donzelot/Transceiver/CHANGELOG.txt

----Version 9.4.0----
+HARDW: Wolf-2: Добавлена новая экспериментальная УКВ плата 85-2700МГц. Автор R7KBI
+HARDW: Стандартизирована распиновка разъёма External для всех версий TRX, схема подключения находится в файле Stuff/Manuals/External.png. Автор R3TJL
+STM32: Добавлена регулировка громкости самопрослушивания в CW. Автор RA3RBE, Tnx SP7MFR
+STM32: Удалена опция отключения самопрослушивания в связи с возможностью плавной регулировки громкости.  Автор RA3RBE
+STM32: Изменен порядок регулировок в меню CW. Автор RA3RBE
+STM32: Исправление вывода даты в меню настроек. Автор RA3RBE
+STM32: Добавлено выключение режима MUTE вращение регулятора громкости. Выключение этого режима клавишей не отменяется. Автор RA3RBE, Tnx UR7CQ
+STM32: Wolf-2: Добавлена поддержка новой УКВ платы
+STM32: Вернул свайп по водопаду в режиме Center, но инвертировал в Free Tune, Tnx R3TJL
+STM32: Wolf-2: Кнопка VHF переключает активные УКВ бенды, а не только 2м, Tnx Adi
+STM32: Исправлена проблема с зашкаливанием S-метра, Tnx SP7MFR
+STM32: W-Lite: Добавленя матричная обработка клавиш тангенты. Автор RA3RBE
+STM32: В режиме Double всегда отображается второй VFO на водопаде (без необходимости активации Show Sec VFO), Tnx SP7MFR
+STM32: На спектре отображаются границы Manual Notch фильтра, Tnx EA7HOG
+STM32: Обновлён шаг по умолчанию для WFM
+STM32: Добавлена калибровка "FAN Motherboard", включающая вентилятор не только на превышение температуры RF-платы, но и на температуру STM32, Tnx SP7MFR
+STM32: Настройка "Bottom navi buttons" теперь выбирает позицию расположения навигационных кнопок (выкл\центр\по краям), Tnx R3TJL
+STM32: Новая настройка "SPLIT type", в режиме DX - идёт управление частотой DX, в режиме CrossBand синхронно для двух VFO, для Free меняется только частота RX, Tnx UR7CQ
+STM32: Исправлена работа CW макросов при выключенном CW Keyer, Tnx SP7MFR
+STM32: Добавлена кнопка выхода в FT8 декодере, Tnx EA5GSA

----Version 9.3.1----
+HARDW: W-Lite: Исправление типов диодов в схеме MotherBoard. Автор R7KBI
+STM32: W-Lite: Исправлена регулировка скорости водопада. Автор RA3RBE
+STM32: Для CW моды добавил дополнительное предусиление в ПЧ, Tnx RU4PN
+STM32: Обдув в режиме Full теперь работает до установленной температуры, а не до Medium stop, Tnx RU4PN
+STM32: Частота по умолчанию для 2м бенда установлена в 145.500, Tnx R7KBI
+STM32: При активном Free Tune, переключение Zoom/Samples перемещает спектр в центр полосы приёма, Tnx UR7CQ
+STM32: W-Mini: добавлены дополнительные настраиваемые функциональные кнопки (FT8/VOX/...), Tnx R6DLC
+STM32: Исправлена работа функциональной кнопки MEMORY, Tnx SP7MFR
+STM32: Добавлена настройка "Center After Idle", центрирующая спектр Free Tune во время бездействия более 20 секунд, Tnx R7KBI
+STM32: Изменение положения навигационных кнопок на 8-ми кнопочной версии, Tnx SP7MFR
+STM32: В сервис Self Test добавлена палитра для проверки подключения шины LCD панелей
+STM32: Устранение различных ошибок
+STM32: W-Lite: Добавлена настройка экрана (Mirror) при первом старте программы. Автор RA3RBE
+STM32: Обновлены системные библиотеки

----Version 9.3.0----
+HARDW: Wolf-Motherboard-rev34: Исправления в посадочных местах, переход на USB Type-C, разъём для подключения I2C периферии и прочие исправления. Автор R7KBI
+HARDW: Wolf-Front-Unit-7-rev6: Исправления в посадочных местах. Автор R7KBI
+OTA: Сервер обновлений и сервисов переведён в Нидерланды
+STM32: W-Mini: Добавлена поддержка УКВ платы, Tnx R7KBI
+STM32: W-Mini: Автоматический выбор соответствующей функциональной страницы кнопок при активации режима MEMO / моды CW, Tnx R7KBI
+STM32: Добавлена регулировка ручного Notch-фильтра, Tnx EA7HOG
+STM32: Добавлена поддержка бенда 630м и трансвертеров 1.2см
+STM32: Вывод текущей даты на 7 дюймовых дисплеях, Tnx ats52
+STM32: Добавлена "запятая" в окно ручного ввода частоты, Tnx R4HID
+STM32: Устранение ошибок, Tnx ats52
+STM32: W-Lite: Включено декодирование CW сигнала
+STM32: W-Lite: Включены настройки трансвертеров
+STM32: При активации SPLIT принудительно отображается второй VFO на водопаде, Tnx UR7CQ, UT8EU
+STM32: При активации SPLIT свайп\тап по водопаду перемещает вторичный VFO, а не основной, Tnx UR7CQ
+STM32: Функция MEMORY добавлена в нижний ряд настраиваемых кнопок (через меню), Tnx SP7MFR

----Version 9.2.1----
+STM32: Устранение ошибок, Tnx Martin AD, SP7MFR

----Version 9.2.0----
+HARDW: Wolf-2: Обновлена плата УКВ, Автор RU4PN
+HARDW: W-Lite: Исправлена шелкография у стабилизаторов на материнской плате, Tnx Андрей Сергеев
+STM32: Долгое нажатие на водопад переключает режимы Free Tune / Center Tune. Автор BD6MM
+STM32: Улучшена поддержка некоторых видов SD карт, Tnx UN7LAS
+STM32: Обновлены параметры "Repeater offset, kHz" по умолчанию, Tnx SP7MFR
+STM32: Уменьшен уровень передачи записанного WAV файла, Tnx UZ5DM
+STM32: Доработки процесса OTA и прошивки с SD, Tnx RV9CT, SQ7BCN
+STM32: FFT Automatic теперь принимает 3 значения: Full - автоматический выбор верхней и нижней границ, Half - авто нижний и ручной верхний, No - ручное выставление диапазона уровней спектра. (Не забывайте выбрать нужный FFT Scale Type, чтобы диапазон уместился на экране). Tnx ats52
+STM32: ENC2 теперь корректно работает на AM/NFM/WFM модах, обновлены настройки по умолчанию, Tnx R3TKS
+STM32: Прописаны моды по умолчанию за границами бендов, Tnx RU4PN
+STM32: W-Lite: Добавлено управление 6м ФНЧ, Tnx UN7FHS
+STM32: Для 9-ти кнопочных версий (WF-100D / Wolf-2) перемещены кнопки пролистывания к центральной, чтобы надписи соответствовали расположению кнопок, Tnx SP7MFR
+STM32: Устранение ошибок, Tnx R4FZ, SP7MFR, R4HID, RU4PN

----Version 9.1.0----
+HARDW: Motherboard: Обновлён номинал резистора R10 в обвязке аудио-кодека, выбирается по необходимому усилению микрофона, Tnx R3TKS
+STM32: W-Mini: Перестроен интерфейс главного экрана. Иконки режимов работы выстроены в один ряд, увеличено место под основную частоту. Автор RA3RBE
+STM32: W-Mini: Ниже основной частоты выведена частота второго VFO. Автор RA3RBE
+STM32: W-Mini: Добавлен режим каналов. В меню установлены 20 каналов, можно менять им имена, не более 6 букв. Автор RA3RBE
+STM32: W-Mini: Изменен режим SCAN. В режиме MEMO сканирование идет по заполненным каналам памяти. Автор RA3RBE
+STM32: W-Mini: Добавлена иконка работы WiFi. Автор RA3RBE
+STM32: W-Mini: Множество мелких изменений. Автор RA3RBE
+STM32: W-Lite: Открыта регулировка RF GAIN на 6 м. Автор RA3RBE
+STM32: Обновлены настройки АРУ по умолчанию (аккуратней с импортом старых), Tnx R3RM, RU4PN
+STM32: Разделены настройки "AGC Gain target" для CW и SSB, Tnx R3RM
+STM32: Добавлена настройка HPF фильтра для DIGI мод, Tnx SP3JDZ
+STM32: Repiter mode теперь сохраняется в память частот, Tnx SP7MFR
+STM32: Переработаны настройки шага перестройки частоты: Для каждой моды выставляется свой базовый шаг, и настраивается множитель для FAST и ENC2 шагов
+STM32: Добавлена возможность настроить индивидуальный шаг перестройки для DIGI мод, Tnx SP7MFR
+STM32: Устранение ошибок, Tnx Serg, R4HID

----Version 9.0.1----
+STM32: Исправлена ошибка "Line length error", Tnx SP7MFR
+STM32: Добавлен кГц разряд при сохранении в память частоты >100МГц, Tnx SP7MFR
+STM32: Добавлена настройка "ATU Mem step, kHz", регулирующая шаг ячеек памяти автотюнера, Tnx R7KBI
+STM32: Исправлена ошибка с полным пропадаем звука в WFM

----Version 9.0.0----
+FPGA: W-Mini: Добавлены прошивки с поддержкой новых плат
+STM32: W-Lite: Добавлены команды САТ интерфейса DN,UP. Автор RA3RBE
+STM32: Начало разработки Satellite Mode (режима работы через спутники). Реализовано скачивание TLE, выбор спутника и отображение элевации\азимута для текущего QTH
+STM32: Исправлена работа команды САТ интерфейса NR, Thanks Кшисек SP7MFR. Автор RA3RBE
+STM32: Оптимизация скорости работы математических функций
+STM32: В режиме FT8 добавлена регулировка мощности основным энкодером при ТХ, Tnx RU4PN
+STM32: Wolf-2: Увеличена точность определения нажатия на кнопки лицевой панели
+STM32: Wolf-2: Добавлена возможность регулировки полосы фильтра в модах DIGI отдельным энкодером
+STM32: Ручной ввод частоты вынесен в отдельную кнопку
+STM32: По умолчанию, при сохранении частоты в память, в название канала пишется частота, далее можно отредактировать имя через меню
+STM32: Wolf-Mini: Добавлена регулировка IF Gain второстепенным энкодером
+STM32: Для каждого канала памяти индивидуально сохраняется настройка CTCSS, Tnx SP7MFR+SP7GRV
+STM32: Вернул старый CW декодер, но с исправлениями проблем, Tnx BD6MM
+STM32: Улучшена защита от проглатывания первой точки в CW, Tnx BD6MM, Serg
+STM32: Переработан код электронного ключа для более точной генерации символов, Tnx BD6MM
+STM32: Добавлена настройка CW "Edges smooth, ms", отвечающая за сглаживание фронтов сигнала
+STM32: При выходе из FT8 декодера трансивер возвращается в предыдущую частоту\моду, Tnx UN7LAS
+STM32: Устранение ошибок, Tnx UZ5DM, ats52, EA7HOG, BD6MM

----Version 8.6.4----
+STM32: W-Lite: Добавлены команды САТ интерфейса NB,NR,NT,PA,RA. Автор RA3RBE
+STM32: W-Lite: Расширена область приема АМ вниз до 100кгц, Автор RA3RBE
+STM32: Вернули настройку Encoder2 on fall, настраивающую режим работы ENC2
+STM32: Переделан механизм анти-дребезга энкодера (аккуратнее с импортом старых калибровок ENC2, могут не подойти)
+STM32: Вернул регулировку уровня предусиления перед сжатием сигнала "CESSB Compress"
+STM32: Добавлена поддержка трансвертеров на 144мгц, Tnx R6DLC
+STM32: Устранение ошибок, Tnx R6DLC, RA9N

----Version 8.6.3----
+STM32: W-Lite: Подвинул индикатор полосы пропускания и подпись под ним, Автор RA3RBE
+STM32: Устранение ошибок, Tnx R3RM, R7KBI

----Version 8.6.0----
+STM32: W-Lite: Расширил место под АТТ, Автор RA3RBE
+STM32: W-Lite: Перестановки в карусели, Автор RA3RBE
+STM32: W-Lite: Убрал клавишу IF и вместо нее сделал CESSB, Автор RA3RBE
+STM32: W-Lite: Ограничил перестройку "по кругу" IF GAIN, Автор RA3RBE
+STM32: W-Lite: Вернул в карусель клавиши BAND+, BAND- и NB, Автор RA3RBE
+STM32: W-Lite: на спектре выводятся маркеры сохраненных частот, маяков, смещение от несущей в SAM
+STM32: W-Mini: Добавлен "пиксель" в правой части экрана, отображающий статус WiFi соединения, Tnx R7KBI
+STM32: W-Mini: управление NB выведено в нижнюю карусель функциональных кнопок, Tnx R7KBI
+STM32: Переработка Noise Blanker, Tnx R3RM, RA3RBE
+STM32: Переделаны функции-обработчики сигналов с энкодеров, Tnx RA3RBE
+STM32: Добавлена настройка VCXO Correction для точной подстройки отклонения частоты генератора от эталонного
+STM32: Добавлена поддержка 12.8МГц TCXO, Tnx ats52
+STM32: Разделены настройки Mic Gain для AM и FM
+STM32: На спектре выводятся маркеры сохраненных в память частот, Tnx Martin AD
+STM32: Добавлена настройка "FFT BW Position" для регулировки положения отрисовки полосы приёма на FFT\WTF
+STM32: Добавлен режим "Delay" для "FFT BW Position" (отрисовка с временной задержкой), Tnx ats52
+STM32: ATU теперь хранит настройки с шагом в 50кГц для каждой антенны, Tnx UT8EU
+STM32: Увеличено количество каналов памяти на 7 дюймовках, Tnx SP7MFR
+STM32: Оптимизация работы CW декодера
+STM32: Добавлена настройка "A/B Balance", регулирующая баланс каналов в режимах двойного приёмника A+B и A&B, Tnx SP7MFR
+STM32: Если режим вторичного энкодера переключен на "MEM", и есть сохранённые частоты в память, то функция SCAN ведётся по ним, Tnx EA7HOG
+STM32: Отключена компрессия в CESSB, оставил только контроль огибающей квадратуры
+STM32: Устранение ошибок, Tnx RV9CT, UN7FHS, SP7MFR, UZ5DM, BD6MM, R7KBI, Adi, Vit

----Version 8.5.1----
+STM32: Устранение ошибок

----Version 8.5.0----
+HARDW: Доработки по плате тюнера Wolf-2, Tnx RU4PN
+STM32: Доработки по работе основного энкодера в системном меню, Tnx RA3RBE
+STM32: Уменьшен шаг калибровки шунта INA226, Tnx R5ZX
+STM32: Добавлена поддержка плат с 4 антенными выходами, Tnx R2AJI
+STM32: Изменён цвет подсветки при отображении второго VFO на спектре, Tnx SP7MFR
+STM32: Добавлены узкополосные SSB фильтры, Tnx SP7MFR
+STM32: Для RTTY декодера устанавливается узкая полоса фильтра, Tnx EA7HOG
+STM32: Добавлено меню редактирования названий каналов памяти, Tnx Martin AD
+STM32: Записи эфира складываются в отдельную директорию Recordings, Tnx Martin AD
+STM32: W-Lite: Убраны квадраты вокруг индикаторов режимов как не несущие полезной нагрузки, только загромождающие экран, Автор RA3RBE
+STM32: W-Lite: Индикаторы распределены равномерно по сторонам экрана визуально разгружая центр экрана, Автор RA3RBE
+STM32: W-Lite: Выведена на экран частота второго VFO, Автор RA3RBE
+STM32: W-Lite: Режимы второго энкодера выделены на экране белой рамочкой, Автор RA3RBE
+STM32: W-Lite: Удалена клавиша "LOCK", блокировка трансивера осуществляется нажатием на кнопку второго энкодера, Автор RA3RBE
+STM32: W-Lite: Скорость работы основного энкодера уменьшается в 10 раз при переходе в меню. Это удобно при наборе имени и прочего, Автор RA3RBE
+STM32: W-Lite: Добавлены 20 ячеек памяти. Можно запоминать в них текущую частоту, читать частоту из памяти и присваивать ее основной частоте, Автор RA3RBE
+STM32: W-Lite: Можно стирать содержимое ячейки, если повторно записать в нее ту же самую частоту, Автор RA3RBE
+STM32: W-Lite: Режим работы с памятью выбирается нажатием на кнопку второго энкодера до появления надписи "Memory". Перебирать каналы можно вращением второго энкодера. Запись в память и извлечение из нее осуществляется кнопками в нижней прокрутке "Mem->Fr" и "Fr->Mem", Автор RA3RBE
+STM32: W-Lite: Добавлен индикатор “SPLIT” в режиме SPLIT, при смене диапазона режим SPLIT выключается, Автор RA3RBE
+STM32: W-Lite: Добавлен индикатор “MUTE” при долгом нажатии на клавишу MUTE, Автор RA3RBE
+STM32: W-Lite: При длительном нажатии на клавишу AGC сделан переход в пункт меню AGC MAX GAIN, Автор RA3RBE
+STM32: W-Lite: Уточнены константы работы с тангентой MH-48, Автор RA3RBE
+STM32: Добавлен режим "CW In SSB", позволяющий на передачу работать телеграфом, возвращаясь обратно в SSB на приём, Tnx SP7MFR
+STM32: Режимы SAM-LSB и SAM-USB вынесены в отдельные моды, Tnx ats52
+STM32: Устранение ошибок, Tnx RA3RBE, R3TKS, UR8IP, SP7MFR, Papandupolo, UR5VLC, Виталий

----Version 8.4.2----
+STM32: Устранение ошибок, Tnx R3RM, SP7MFR, RA3RBE, R7KBI

----Version 8.4.0----
+STM32: В калибровках реализован выбор сопротивления шунта цепи INA226 датчика
+STM32: Поддержка нескольких наборов калибровок для импорта\экспорта, Tnx UT8EU
+STM32: AGC Threshold отключается при активном DNR
+STM32: Разнесены настройки Mic Gain для AM/FM и SSB мод, Tnx R6DLC
+STM32: В калибровки добавлена RF-плата "NONE", выбранная по умолчанию, Tnx Vit
+STM32: Добавлена калибровка скорости вентилятора в Medium режиме, Tnx RU4PN
+STM32: Добавлено отображение других пользователей трансивера Волк на спектре через WiFi. Настройка называется "Wolf Cluster", Tnx RV9XG
+STM32: Добавлена калибровка для компенсации аттенюатора на с-метре, Tnx ats52
+STM32: Добавлена настройка шага регулировки ручного Notch-фильтра, Tnx EA7HOG
+STM32: Добавлен режим Free Tune, позволяющий перемещать полосу приёма по спектру не меняя центральную частоту самого спектра, Tnx R7KBI
+STM32: При отключении тюнера отображается соответствующая надпись на CN/CN+ темах, Tnx SP7MFR
+STM32: Добавлен выбор режима работы SAM демодулятора: Stereo\LSB\USB, Tnx ats52
+STM32: Добавлена возможность переименовывания названий CW макросов на функциональных кнопках, Tnx UZ5DM
+STM32: На CN/CN+ темах выводится текущий WPM в CW моде, Tnx R9IT
+STM32: На CN/CN+ добавлена возможность открыть окно выбора моды VFO-A, Tnx F4EXB
+STM32: Доработки оформления системного меню, Tnx BD6MM
+STM32: Во время записи\воспроизведения файла в файл-менеджере отображается время, Tnx BD6MM
+STM32: Добавлена функция Auto CW, переключающая моду на CW при работе ключом, Tnx SP7MFR
+STM32: Разделены настройки фильтров VFO-A и VFO-B, Tnx SP7MFR
+STM32: Wolf-Lite: Поддержка стилей FFT контур и градиент+контур, Tnx RA3RBE
+STM32: Wolf-Lite: Различные оптимизации, Tnx RA3RBE
+STM32: Устранение ошибок, Tnx RC3RF, ats52, R3RM, RA3RBE, Alex, Гена, R7KBI

----Version 8.3.1----
+STM32: Бенды 6м\FM\2м теперь отключаемы через калибровки
+STM32: Wolf-2 Кнопка TX переключает между TX/RX, а не включает TX только во время нажатия, Tnx UT8EU
+STM32: Добавлена настройка "RX AUDIO Mode", позволяет управлять линиями аудио: стерео, только левый канал, только правый, Tnx RU4PN
+STM32: Добавлена калибровка датчика INA226 по напряжению, Tnx RU4PN
+STM32: Добавлена калибровка переворота тачпада по вертикали, Tnx UT8EU
+STM32: Добавлена настройка "AGC Threshold", включающая порог открытия АРУ, Tnx R7KBI
+STM32: Устранение ошибок, Tnx RU4PN, Дмитрий, R5ZX, Alex

----Version 8.3.0----
+STM32: Добавлен Self Test для диапазона 145МГц, Tnx Serg Iv
+STM32: Добавлены калибровки для индивидуальной настройки функций DTR/RTS линий CAT/Debug портов
+STM32: Добавлена калибровка для инверсии IQ сигнала, передаваемого по USB, Tnx Виктор Георгиевич
+STM32: В Self Test добавлена проверка звука (вывод сигнала в левый и правый канал), Tnx RU4PN
+STM32: Доработки для Wolf-Mini, Tnx R7KBI
+STM32: Различные оптимизации кода
+STM32: В настройки выведен выбор уровня принимаемого стерео-FM канала
+STM32: Добавлен 8кГц эквалайзер для WFM, Tnx R7KBI
+STM32: Обновление настроек эквалайзера для выравнивания АЧХ по умолчанию (не используйте предыдущие настройки), Tnx R7KBI
+STM32: Во время передачи встроенным FT8 блокируется управление частотой главным энкодером, Tnx UZ5DM
+STM32: Добавлен сервис, отображающий прогноз тропосферного прохождения (регион выбирается в настройках), Tnx Martin AD
+STM32: Добавлена возможность сохранять\загружать 3 комплекта настроек под разные нужды, Tnx Martin AD
+STM32: Экспорт\импорт настроек и калибровок разделен по разным файлам (полезно при обновлении прошивки, чтобы импортировать только калибровки)
+STM32: Настройки RX LPF CW/SSB/AM/FM фильтров сохраняются для каждого диапазона индивидуально, Tnx DL1EGQ
+STM32: Устранение ошибок, Tnx R6DLC, R7KBI, UZ5DM, Martin AD

----Version 8.2.0----
+STM32: Wolf-Mini: отображаются активные функции в нижнем меню, Tnx R7KBI
+STM32: Кнопки пагинации в нижнем меню перекрашены в отдельный цвет, Tnx R7KBI
+STM32: Добавлен простой алгоритм сглаживания границ экранных шрифтов, Tnx Aleksey Thunder
+STM32: Добавлено увеличение спектра x32 (полоса 1.5кГц при samplerate 48кГц), Tnx UR8IP
+STM32: Строка с рапортом теперь выводит S9+ значения кратно 5, Tnx R7KBI
+STM32: Режим отображения спектра по умолчанию выставлен в градиент+контур
+STM32: Добавлена FT8 частота для QO-100 трансвертера 10.489.540, Tnx UR8IP
+STM32: Wolf-2: Датчик INA226 включен по умолчанию 
+STM32: Wolf-2: Добавлены сочетания клавиш при запуске: F1 - сброс настроек, F1+F9 - сброс настроек и калибровок, Tune - переход в режим DFU
+STM32: Громкость самоконтроля CW теперь не зависит от общей громкости трансивера, Tnx UZ5DM
+STM32: Wolf-Mini: На экран выводятся текущие значения ATU, Tnx R7KBI
+STM32: Добавлен шаг перестройки AM равный 8.33кГц, Tnx Martin AD
+STM32: Wolf/Wolf-X1/Wolf-2: Частота тактирования ЦАП автоматически адаптируется в зависимости от бенда чтобы избегать пораженных частот на 6м, Tnx DD8BA 
+STM32: Увеличен порядок TX фильтра Гильберта
+STM32: В меню калибровок вынесены настройки тачпада (пороги и время срабатываний), Tnx Martin AD
+STM32: Режим FAST сохраняется для каждого бенда отдельно, Tnx R6DLC
+STM32: Устранение ошибок, Tnx RU4PN, R7KBI, SP3JDZ

----Version 8.1.2----
+STM32: Устранение ошибок, Tnx SP5TAA, R7KBI, DJ0AK, Виталий, SP3JDZ

----Version 8.1.0----
+HARDW: Обновлены версии плат Wolf-2, Tnx RU4PN
+STM32: Устранены лишние циклы переключений на ВЧ плате RU4PN
+STM32: В режиме Two Signal Tune отключено ограничение мощности по калибровке (Max Tune power)
+STM32: Кнопка Tune в нижнем меню подсвечивается при активном ATU, Tnx RA3WSA
+STM32: Долгим нажатием на кнопку Tune включается\отключается ATU, Tnx UT8EU, UZ5DM
+STM32: Во время записи на SD и воспроизведения с SD в эфир не применяются настройки эквалайзера, Tnx R3TKS, R6DLC
+STM32: Максимальная длина CW макросов увеличена до 60 символов (большие макросы проще редактировать через файл настроек), Tnx UZ5DM
+STM32: Добавлена проверка версии FPGA при запуске, Tnx UA3AAE
+STM32: Добавлен режим "градиент+контур" для настройки FFT Style, Tnx UZ5DM
+STM32: Устранение ошибок, Tnx R9FDL, Виталий, UT8EU, R7KBI, UZ5DM

----Version 8.0.0----
+HARDW: Добавлена плата внешнего PLL для использования внешнего генератора (например GPSDO) в качестве опорного (Папка Schematic\Wolf\Addons\PLL_DL2FW). Автор DL2FW
+HARDW: Устранение ошибок W-Lite, Tnx R7KBI
+FPGA: Уменьшение джиттера тактового сигнала ЦАП
+STM32: Первые эксперименты с Digital-Pre-Distortion (функция скрыта в программируемые кнопки нижнего меню, долгое нажатие - запуск калибровки под текущий бенд)
+STM32: Оптимизации кода
+STM32: Добавлено управление "FT8 Auto CQ" через настройки, Tnx SP7DQR
+STM32: Файл лога FT8 переименован в FT8_QSO_Log.adi, Tnx SP7DQR
+STM32: Вывод количества QSO (строк) в логе FT8, Tnx Анатолий Митрофанов
+STM32: Синтез тона FT8 вместо девиации частоты передатчика, Tnx RV9CT
+STM32: Перевод WiFi сервисов на международный домен
+STM32: Синхронизирован размер полосы ZoomFFT на больших значениях приближения при переходе с RX на TX, Tnx R7KBI
+STM32: Обновление цветов кнопок пагинации нижней панели, Tnx R7KBI
+STM32: Добавлена калибровка датчика KTY81 (установка сопротивления плеча делителя), Tnx R6DLC
+STM32: Обновления для поддержки последних версий плат Wolf-2, Tnx RU4PN
+STM32: Уменьшена частота опроса датчика мощности (для повышения точности измерений)
+STM32: Устранение ошибок, Tnx K4BAC, RU4PN, SP7DQR, R9IT, RU4PN, R7KBI, RC9M

----Version 7.6.0----
+HARDW: Обновлены номиналы обвязки ЦАП, рекомендуется всем актуализировать элементы на своих платах для улучшения качества сигнала, Tnx RA6UAC
+FPGA: Доработки шины обмена с STM32
+STM32: Доработки CW Гаусс фильтра, Tnx R9IT, UT8EU, RU4PN
+STM32: Добавлено меню установки даты, Tnx RN3OZ
+STM32: Добавлена сортировка по имени в файл-менеджере SD карты
+STM32: На клавиатуру добавлены кнопки с символами, раскрашены кнопки enter\backspace\shift, Tnx VU2OBR, R3DBQ
+STM32: В помощь для настройки IF Gain, на спектре отображается текущий уровень АРУ
+STM32: Доработки АРУ + новые настройки задержки усиления АРУ на пиках, Tnx RU4PN
+STM32: Добавлено подменю "Time beacons" в меню "Services" со списком маяков точного времени, Tnx R2AJI
+STM32: На спектре отображаются метки для частот маяков точного времени, Tnx R2AJI
+STM32: При работе в моде SAM отображается разница между частотой приёмника и несущей. Для подстройки частоты опорного генератора по АМ станциям и маякам точного времени (во время передачи постоянной несущей), Tnx R2AJI
+STM32: Добавлен выбор типа ямбического ключа (A / B), Tnx Антон Ивачев
+STM32: Добавлен режим ключа с памятью на один символ, Tnx UT8EU
+STM32: Устранение ошибок, Tnx SP7SP, DL1EGQ, RU4PN

----Version 7.5.0----
+HARDW: Добавлена 3д модель панели для 7 дюймовой версии, Tnx Александр
+STM32: Доработки по цветам меню (вошли в 7.4.1), Tnx R3DBQ
+STM32: Воспроизведение CQ теперь останавливается при повторном нажатии на кнопку, Tnx R4HID
+STM32: Поддержка дробных таймзон (например +3:30), Tnx VU2OBR
+STM32: Увеличен шрифт меню установки времени для 3'5 дюймовых дисплеев, Tnx С1-49
+STM32: Добавлена возможность выбора HPF фильтра в NFM моде, Tnx R6DLC
+STM32: Добавлены настройки "LINE Gain" и "CODEC Gain" для регулировки аппаратного усиления (в кодеке) линейного входа и НЧ выхода
+STM32: Добавлена настройка "ALC Inverted", инвертирующая логику ALC порта (1.0v - 100% мощности, 3.0v - 0%), Tnx SP7SP
+STM32: Добавлена NOFPGA версия прошивки STM32 для Wolf-2, Tnx RU4PN
+STM32: Устранение ошибок, Tnx Андрей, RU4PN, Евгений J, R6DLC, R9IT, R5ZX

----Version 7.4.1----
+HARDW: Обновлены платы для проекта Wolf-2, Tnx RU4PN
+STM32: Устранение ошибок, Tnx R4HID, RU4PN, R6DLC, RA9UCN

----Version 7.4.0----
+STM32: Добавлена настройка "Bottom navi buttons", отображающая кнопки навигации по страницам нижних навигационных кнопок, Tnx R4HID
+STM32: Для настраиваемых функциональных кнопок добавлен режим "NONE", скрывающий кнопку. Если страница содержит только скрытые кнопки - она тоже скрывается из навигации, Tnx R4HID
+STM32: Для второстепенного энкодера добавлена функция перехода между сохранёнными частотами в память (при их наличии), Tnx DL1EGQ
+STM32: Исправление ошибки с отключением FT8, Tnx RV9CT
+STM32: Сокращен интервал синхронизации времени через интернет, Tnx RV9CT
+STM32: Изменён внешний вид системного меню для поддержки тачпада (для 7 дюймовой версии)
+STM32: Устранение мелких ошибок, Tnx R7KBI

----Version 7.3.0----
+HARDW: Добавлены платы и схемы проекта WOLF-2, Tnx RU4PN
+HARDW: Добавлена инструкция для подключения управления внешним усилителем к WF-100D, Tnx SP7DQR, SP7SP
+STM32: Реализована возможность одновременной работы RIT и XIT (для Fine RIT Tune), Tnx UA3RBM
+STM32: Исправления в регулировке калибровок BPF, Tnx R6WAM
+STM32: Доработки по Wolf-2, Tnx RU4PN
+STM32: Доработки по Wolf-Mini, Tnx R7KBI
+STM32: Кнопка Split перемещена ближе к A/B, Tnx SP7SP
+STM32: Repeater Mode теперь настраивается для каждого VFO/бенда раздельно
+STM32: Добавлена настраиваемая функциональная кнопка "Repeater Mode" для нижней панели
+STM32: Перетряхнули меню настроек и калибровок, Tnx RU4PN
+STM32: Уменьшена ступенька на минимуме регулировки громкости, расширен диапазон регулировки в дБ, Tnx R4HID
+STM32: Работает самоконтроль во время передачи WAV в эфир, Tnx R4HID
+STM32: Добавлен режим отладки ошибок I2C (Debug Console), Tnx RU4PN
+STM32: Устранение мелких ошибок, Tnx C1-49, R7KBI

----Version 7.2.0----
+STM32: Автоматическая отправка FT8 связей в онлайн-журнал https://allqso.ru/ (подробнее о журнале на сайте), Tnx RU4PN
+STM32: Немного улучшена отзывчивость тачпада
+STM32: Wolf-2: Доработка управления с лицевой панели
+STM32: При выключенном режиме Fast корректно считает шаг перестройки в AM/FM/WFM
+STM32: Настройки ATU сохраняются для каждой выбранной антенны отдельно, Tnx R4HID
+STM32: Настройки по бендам, в том числе ATU, сохраняются на SD при экспорте, Tnx RU4PN
+STM32: Добавлена настройка "Split freq sync", отвечающая за синхронное изменение частоты VFO в SPLIT режиме, Tnx SP7SP
+STM32: Добавлена настройка "DX Cluster Type", отвечающая за выбор источника данных кластера (reversebeacon.net или dxsummit.fi), Tnx SP7SP
+STM32: CESSB активирован по умолчанию (с предусилением в 1дб, настройте по вкусу)
+STM32: Добавлен режим работы через репитеры "Repeater Mode" со смещением во время передачи из настройки "Repeater offset, kHz", Tnx EA7HOG

----Version 7.1.0----
+STM32: Исправлен запуск ATU при первом старте CQ в FT8, Tnx RU4PN
+STM32: Добавлены 60m и 70cm бенд во встроенный FT8, Tnx DL1EGQ
+STM32: Расширен выбор шага перестройки до 100гц в AM и FM модах
+STM32: Добавлена регулировка крутизны фильтров для CW и SSB мод (помогает от звона)
+STM32: Исправлена проблема с обновлением значка ANT при смене бенда энкодером, Tnx Юрий Колесников
+STM32: Исправлена проблема с импортом значений калибровок QO-100, Tnx UR5VLC
+STM32: Добавлены отдельные настройки эквалайзера для WFM моды, Tnx EA7HOG
+STM32: WF-100D: При смене диапазона кнопками меняется частота открытого FT8 декодера, Tnx RU4PN
+STM32: Исправление разных ошибок

----Version 7.0.0----
+HARDW: Новая версия платы RF-UNIT-BIG-RU4PN-rev5.5, Tnx RU4PN
-Убрано одно звено режекторного фильтра 144МГц, меньше затуханий без потери режекции + переразведен сам RX BPF 2m
-Скорректированы номиналы в УКВ-фильтрах RX/TX
-Выходной BPF 144 переделан в LPF, меньше потери
-Питание на RD16 теперь берется с питания RD100
-Переделаны переходные отверстия - исключены из PADов элементов, на что постоянно ругались инженера JLCPCB
-Переделана коммутация LNA для исключения самовозбуда в некоторых ситуациях
-FB1 и FB2 заменены на BLM21 SMD
-Добавлены резисторы в цепи управления ключей BIAS_ON
-В цепи смещения РД16, РД100 внесены небольшие правки, добавлены емкости
-По затворам РД100 добавлены супрессоры для защиты
-Косметические правки

+HARDW: Добавлена плата Wolf-Adapter-rev2 предназначенная для управления внешними усилителями\трансвертерами\МШУ\фильтрами (максимум 16 каналов) через External порт трансивера, Tnx R7KBI

+STM32: Доработки FT8, Tnx RU4PN, RA6UAC
+STM32: Добавлена поддержка трансвертеров\бенда QO-100, Tnx UR8IP
+STM32: Добавлена функция "Full Duplex" - включает режим одновременного приёма и передачи (можно увидеть свой сигнал), использовать осторожно и не допускать перегрузки входных цепей
+STM32: Расширен список значений для Freq Step FM, Tnx UR5YDW
+STM32: Корректировка границ бендов, Tnx R2AJI
+STM32: Добавлена регулировка скатов фильтров AM/FM настройкой "AM/FM LPF Stages" (больше - круче скаты), Tnx UR5YDW
+STM32: Добавлена калибровка "MAX ChargePump, kHz" для ограничения максимальной частоты ШИМ VCXO корректора, стоит корректировать при проблемах с стабилизацией частоты
+STM32: Доработки CW Decoder
+STM32: Добавлена поддержка FT8 для экранов 320x240 (Wolf-Mini, Wolf-Lite-2), Tnx DJ0AK
+STM32: Wolf-X1: на быстрые кнопки добавлено управление драйвером АЦП, Tnx RU4PN
+STM32: Калибровки "по умолчанию" для External порта установлены под использование платы Wolf-Adapter
+STM32: Добавлена калибровка "ALC Port Enabled" - включающая управление мощностью трансивера внешним усилителем по линии ALC, Tnx R6WAM

----Version 6.8.2----
+STM32: Восстановлена работа прошивальщика FPGA с SD карт (для прошивок FPGA 6.8.0 и далее)
+STM32: Восстановлена работа FT8
+STM32: W-Lite: Исправление переключения Sample Rate, Tnx UN7FHS

----Version 6.8.1----
+STM32: Улучшен процесс подключения SD карты
+STM32: Ограничена частота ШИМ ChargePump

----Version 6.8.0----
+FPGA: Переход на Quartus 22.1 Standart
+FPGA: Добавлена функция отключения VCXO корректора
+FPGA: Добавлена прошивка для Wolf-Lite-2, Tnx DJ0AK
+FPGA: Новый корректор VCXO частоты, Tnx DJ0AK, EU1SW
+STM32: Частота TCXO генератора теперь выбирается в STM32, поддерживаются модели: 5.12, 8, 9.6, 10, 12, 12.288, 13, 14, 14.4, 15, 16, 16.8, 19.2, 19.44, 19.68, 20, 20.48, 24, 25, 26, 27, 28, 30, 32, 38.4, 40, 50 МГц
+STM32: Добавлены настройки шага перестройки частоты для FM/AM мод, Tnx DJ0AK
+STM32: Корректировка бендмапа CB диапазона, Tnx DJ0AK
+STM32: Доработки ATU, Tnx RU4PN
+STM32: Добавлены FT4/FT8/MSK144 регионы на бендмапе 2m/70cm/23cm/13cm/6cm/3cm
+STM32: Добавлена возможность управления бендами (трансвертерами) 23cm/13cm/6cm/3cm через CAT
+STM32: W-Lite: Изменены цвета С-метра на S9+, Tnx R7KBI
+STM32: W-Lite: Доработка управления кнопкой Menu при открытом меню настроек, Tnx RL6MR
+STM32: Доработки FT8 при нестандартных последовательностях ответов (требуется тестирование), Tnx RW4CPA
+STM32: При записи связи FT8 в лог корректно рассчитывается дата\время в UTC исходя из настроек текущей временной зоны, Tnx RU4PN
+STM32: Обновлены тайминги ШИМ RA8875
+STM32: Исправление мелких ошибок

----Version 6.7.0----
+STM32: В режиме отладки Debug console = System в консоль выводятся усреднённые данные о dBm приёмника, полезно для измерений Noise Figure усилителей
+STM32: В случае перегрузки КСВ/ALC датчика выводится значок ошибки OVS, Tnx R7KBI
+STM32: Расширены границы подстройки FFT Automatic, Tnx R4HID
+STM32: 7Inch: Доработка процесса пробуждения LCD от сна по тачу на экран, Tnx DL1EGQ
+STM32: Исправление ошибок переключения режимов ENC2, Tnx DL1EGQ
+STM32: Добавлены прототипы прошивок для Wolf-2, Wolf-Lite-2, Wolf-Mini, Tnx RU4PN, DJ0AK, R7KBI
+STM32: При переключении на WFM не сбрасывается настройка Zoom, Tnx R7KBI
+STM32: Обновлены настройки FFT/WTF во время передачи, Tnx R7KBI
+STM32: Нет ошибок при сбросе настроек\калибровок через меню
+STM32: На Analog/CN темах КСВ выводится с точностью до сотых, Tnx R7KBI
+STM32: Исправлена проблема с TX Start Delay во встроенном FT8, Tnx RU4PN
+STM32: Реализован механизм CW макросов для передачи заранее сформированных сообщений, Tnx R7KBI
+STM32: RIT/XIT не сбрасываются в ноль при повторном включении, Tnx АлександрDX
+STM32: Уточнены границы вещательных бендов, Tnx R2AJI
+STM32: На FFT и в Services->DX Cluster теперь дополнительно выводится информация о AM вещательных станциях (название, страна, мощность), Tnx R2AJI
+STM32: Для встроенного FT8 добавлен диапазон 160m
+STM32: Wolf-Lite: изменение управления, короткое нажатие Menu листает функциональные кнопки, долгое - вход в меню, долгое нажатие на ENC2 - Lock и калибровки, Tnx RL6MR

----Version 6.6.0----
+STM32: Добавлена калибровка RF Gain для 60м и СВЧ бендов, Tnx EA7HOG
+STM32: Кнопка Play переименована в CQ во избежание путаницы, Tnx R6TW
+STM32: Обновлены системные библиотеки
+STM32: Исправления в работе Spectral AGC
+STM32: Исправлен процесс обновления STM32 по OTA на WF-100D аппаратах, применится только со следующего обновления после 6.6.0, Tnx RV9CT
+STM32: При работе через CAT корректно восстанавливаются настройки по диапазонам (например тюнер), Tnx RA9N
+STM32: Обновлены выбранные частоты бендов и трансвертеров "по умолчанию"
+STM32: 7Inch: Добавлена возможность удаления сохранённых MEM частот с помощью повторной записи в ту же ячейку, Tnx EA7HOG
+STM32: 7Inch: Долгое нажатие на кнопку Services сохраняет скриншот экрана на SD карту, Tnx EA7HOG
+STM32: Полупрозрачный маркер полосы на водопаде изменяет свой размер от ширины HPF фильтра
+STM32: Улучшение работы FFT за счёт новой оконной функции Generalized adaptive polynomial optimized Nuttall
+STM32: De-emphasis функция теперь выполняется в аудио-кодеке

----Version 6.5.0----
+FPGA: Улучшена стабильность по приёму
+FPGA: Доработка алгоритма VCXO корректора
+STM32: Исправление оформления в self-test, Tnx Григорий Потемкин
+STM32: WF-100D: На X16 (U32) выведены сигналы EXTERNAL (выбор бенда или трансвертера)
+STM32: При перегрузке по ПЧ (IF Gain), и в следствие нестабильной работы АРУ с искажениями, выводится значок IFO
+STM32: W-Lite: убран пункт меню WiFi settings reset, Tnx C1-49
+STM32: CW Decoder теперь работает и во время передачи, Tnx BD6MM
+STM32: Мелкие исправления по интерфейсу
+STM32: Доработка процесса выхода LCD из затенённого режима, Tnx DL1EGQ

----Version 6.4.0----
+HARDW: Добавлен небольшой README файл по типам лицевых\вч плат
+STM32: Доработки темы для экранов с разрешением в 320 пикселей, Tnx DJ0AK
+STM32: Исправление сохранения последних частот по бендам, Tnx R2AJI
+STM32: Теперь есть возможность настройки ВЧ и ПЧ частот для каждого трансвертера отдельно (70cm/23cm/13cm/6cm/3cm)
+STM32: Актуализирована часть настроек по умолчанию
+STM32: Добавлена настройка "Power for each band", позволяющая устанавливать выходную мощность для каждого бенда\трансвертера отдельно
+STM32: Добавлена настройка "Power for each mode", позволяющая устанавливать выходную мощность для каждой моды отдельно, Tnx DJ0AK
+STM32: Долгое нажатие на экранную кнопку "NB" открывает настройки NoiseBlanker, Tnx RA9N
+STM32: Добавлена калибровка "TOUCHPAD horiz flip", отражающая работу тачпада по горизонтали (для некоторых версий GT911), Tnx RV9CT
+STM32: На не-CN темах восстановлена обводка вокруг кнопок
+STM32: Обновлены цвета цифрового S-метра для S9+ зоны (Волк 3'5+7), Tnx R7KBI
+STM32: На экран выводится выбранный уровень мощности (Волк 7'), по тапу открывается меню с выбором мощности
+STM32: Доработка оформления меню установки времени, Tnx Григорий Потемкин
+STM32: Переход на Keil 5.38 / CMSIS-DSP 1.14.2
+STM32: W-Lite: Исправлен запуск с входом в режим DFU (Включение при зажатой кнопке Band+)

----Version 6.3.2----
+HARDW: Новая версия платы MOTHERBOARD-rev33 от RA9UCN:
-Фильтр T1 на входе заменен на обычный дроссель (L1001 - с ним "фонит" наружу меньше) 
-Дополнительно развязана шина 13,8В идущая на стабилизатор 12В через L1002. Все эти дроссели, включая L37, унифицированы, типоразмер 0630
-L7 и L37 заменены на меньший размер 7*7 мм (в работе проверены, не греются).
-Линия TX к STM защищена диодом D1002 и зашунтирована (опционально) конденсатором C1001
-Разъём MIC_IN2 заменён на трёхконтактный(добавлен PTT), с возможностью запайки с обратной стороны платы для удобства стыковки с FRONT UNIT
-PTT на микрофонный разьем подается через перемычку R1003
-Добавлен дроссель L9 в цепь питания УНЧ
-Линейный аудиовыход с кодека выведен на разьём для экспериментов с внешним УНЧ
-Премычка "BOOT" вынесена ближе к краю платы для удобства программирования
-Увеличена ширина шин питания и добавлено количество переходных отверстий на них
-По возможности разнесены проблемные для начинающих близкорасположенные детали
-Добавлены отверстия для запайки выводов не SMD трансформаторов
-Добавлены отверстия для запайки выводного кварцевого резонатора на 32768 Гц
-Разъемы под батарею, USB, мини-джеки подвинуты ближе к краю
-Немного оптимизирована разводка ST1S10

----Version 6.3.1----
+STM32: Исправлена работа NB на двойном приёмнике, Tnx R4HID
+STM32: Исправлена работа функциональной кнопки CESSB, Tnx R4HID
+STM32: Wolf-3.5: Исправлена работа кнопки NB, SNAP Left назначена на долгое нажатие Notch, SNAP Right назначена на долгое нажатие на Services, Tnx RA9N

----Version 6.3.0----
+STM32: Корректировки в работе Autogainer
+STM32: Корректировки зон тача LCD
+STM32: В ряд нижних кнопок добавлена функция быстрого управления CESSB (функции кнопок настраиваются в меню), Tnx R9FDL
+STM32: Для большего контроля функция SNAP разделена на SNAP влево и SNAP вправо. Autosnap работает в полосе как раньше, Tnx RU4PN
+STM32: Из ряда нижних кнопок убраны стрелки, остался только свайп влево-вправо
+STM32: Функция SNAP теперь работает в SSB и AM модах (в SSB нет несущей, поэтому точность попадания условная)
+STM32: Изменён алгоритм Noise Blanker
+STM32: В настройки вынесена регулировка порога NoiseBlanker, Tnx RA9N
+STM32: Добавлена цветовая гамма водопада BGYRM (черный->синий->зеленый->желтый->красный->фиолетовый), Tnx UN7LAS
+STM32: На экранную клавиатуру добавлен Enter, который возвращает в меню, Tnx UN7LAS

----Version 6.2.1----
+STM32: Исправлена проблема с отображением частоты VFO-B на CN темах, Tnx BD6MM
+STM32: Исправлена проблема с отображением режима ENC2, Tnx Viktor
+STM32: Изменены настройки по умолчанию (например тип CAT по умолчанию теперь TS-2000)

----Version 6.2.0----
+HARDW: Обновлена версия платы RF-UNIT-QRP-RU4PN-rev3, Tnx автору RU4PN
+HARDW: Обновлена схема и BOM плат QRP/SPLIT: Аттенюатор PE4302 заменён на PE4312 без изменений на плате
+STM32: Теперь трансивер может работать с SD, на которых ранее была ошибка Disk Error, Tnx RU4PN
+STM32: Доработаны шрифты в CN теме
+STM32: Расширена зона для тача и холда кнопок на экране
+STM32: Выводится текущий режим ENC2, Tnx B
+STM32: Сброс настроек WiFi на случай ошибок при прошлых обновлениях
+STM32: Исправление расчёта положения RIT индикатора
+STM32: Исправление работы быстрой настройки SQL через второстепенный энкодер, Tnx Sergo K
+STM32: Исправлено отображение кнопки mode на VFO-B темы CN, Tnx R4HID
+STM32: Реализовано отображение DX-кластера на 3D водопаде, Tnx RV9CT
+STM32: Если прошивка ESP-01 слишком старая, то при запуске выводится ошибка (требуется перепрошивка)

----Version 6.1.0----
+STM32: Новые цветовые схемы "CN", "CN+Green", "CN+White" и темы оформления "CN", "CN+", автор BD6MM
+STM32: Обновлена библиотека работы с файловой системой SD карты
+STM32: Доработки CW Snap, Tnx RU4PN
+STM32: В нижней панели кнопок подсвечиваются включенные функции (7 дюймовая версия), Tnx RU4PN
+STM32: Расширены границы регулировки эквалайзеров RX/TX, Tnx UR5YDW
+STM32: Настройки WiFi вынесены в отдельную область EEPROM, которая не сбрасывается при обнулении калибровок и настроек, Tnx UA9ULT
+STM32: 5-ти полосный эквалайзер вместо 3-х полосного, Tnx UR5YDW
+STM32: Исправлена ошибка с исчезновением звука в FM, Tnx RU4PN
+STM32: Скорректировано усиление в FM, Tnx UN7LAS

----Version 6.0.0----
+HARDW: MOTHERBOARD-rev32: Исправлена полярность c77, c75, c80, c85, c125, c126, Tnx EW6D
+HARDW: MOTHERBOARD-rev32: U21 заменён на LM2940S-12, Tnx EA7HOG
+HARDW: MOTHERBOARD-rev32: Убрана диодная сборка D2 BAT54C, Tnx R7KGA
+HARDW: MOTHERBOARD-rev32: Доработки разводки USB изолятора, Tnx R7KGA
+HARDW: Добавлена новая плата RF-UNIT-QRP-RU4PN-rev2, Tnx RU4PN
+FPGA: Увеличена точность коррекции VCXO. Замечено что на некоторых версиях плат WiFi модуль влияет на синхронизацию генераторов, просаживая питание FPGA, рекомендую добавить электролит рядом с модулем, если есть проблема
+FPGA: Включена коррекция VCXO во время передачи, Tnx RA9N
+FPGA: Добавлена прошивка FPGA NO-TCXO, позволяющая делать коррекцию VCXO через ШИМ без использования опорного генератора
+STM32: Расширены варианты регулировки настройки "Freq Step WFM, kHz", Tnx EA7HOG
+STM32: При переключении в моду WFM сбрасывается значение Zoom, Tnx EA7HOG
+STM32: RDS декодер теперь корректно работает при частоте семплирования в 384кГц, Tnx EA7HOG
+STM32: Для Spectrum analyzer шаг перестройки увеличен до 1МГц, Tnx EA7HOG
+STM32: Улучшение работы с трансвертерами
+STM32: В меню сервисов добавлены помошники в калибровке SWR и выходной мощности
+STM32: Функция CW SWAP, если нет сигнала в полосе, перестраивается на ближайший сигнал, а не сильнейший
+STM32: Auto Snap теперь поддерживает NFM моду, для отслеживания перемещающихся сигналов (например со спутника, экспериментальная функция), Tnx Saw_spb
+STM32: Добавлен тач-интерфейс для кнопок FT8, Tnx R6WAM
+STM32: Улучшена работа FT8 на поиск, Tnx RD3Q
+STM32: Убран всплеск ВЧ сигнала при переходе на передачу
+STM32: Новая экспериментальная функция "TX CESSB" - использование модуляции с контролем огибающей при формировании SSB сигнала. Позволяет получить более пробивной сигнал при той же PEP мощности.
+STM32: Настройка "TX CESSB Compress, dB" - уровень компрессии в CESSB, чем выше - тем больше средняя мощность сигнала.
+STM32: На экран выводится текущий уровень SQL в моде NFM/WFM (7 дюймовая версия), Tnx EA7HOG
+STM32: Доработки OTA
+STM32: В System info выведен текущий уровень ALC с внешнего усилителя
+STM32: Новый алгоритм работы ALC: до 1 вольта - ALC отключен и используется мощность выставленная в трансивере. с 1.0v до 3.3v - регулировка мощности от 0 до 100 %
+STM32: Поддержка Two Signal Tune в моде AM
+STM32: Wolf-X1: исправления оформления, Tnx R7KBI

----Version 5.2.1----
+HARDW: Добавлена новая версия RF-UNIT-BIG-RU4PN-rev5.3, Tnx RU4PN
+STM32: W-Lite: Реализована возможность работы в Windows 7

----Version 5.2.0----
+FPGA: Расширение границ регулировки VCXO Correction, Tnx RA0LCC
+FPGA: Снижение частоты ЦАП для подавления паразитных выбросов (также снизился уровень на выходе ЦАП, необходимо компенсировать калибровками или номиналами драйвера\аттенюатора)
+FPGA: Подготовлены прошивки для 10МГц, 12.228МГц, 13МГц, 20МГц и 25МГц TCXO генераторов 
+STM32: Улучшена работа на СВЧ бендах (через трансвертер)
+STM32: Новая функция Snap (для моды CW), которая подстраивает частоту на самый мощный сигнал в полосе (а если нет такого, то в спектре), Tnx R3MCD
+STM32: Новая функция Auto Snap (долгое нажатие на Snap или в меню), которая подстраивает частоту в полосе автоматически
+STM32: Доработка функции Amp Mute, Tnx RA3WSA
+STM32: Увеличено время отображения всплывающих сообщений, Tnx DL1EGQ
+STM32: Доработка механизма отстройки от DC-DC помех
+STM32: Исправление отображения FFT при Scale Type = dBm, Tnx UN7FHS
+STM32: Отключен микрофонный компрессор для DIGI-мод, Tnx RA9N
+STM32: Исправлено изменение мощности энкодером в режиме Tune, Tnx С1-48
+STM32: Wolf-Lite: Исправлено отображение при запуске Tune вне диапазонов, Tnx RA4CGO
+STM32: Wolf-Lite: Исправлено сохранение IF Gain из функций быстрого доступа, Tnx RA4CGO
+STM32: Доработка автоматики FFT в режиме Squared, Tnx R7KBI
+STM32: В сервис Self Test добавлена проверка частоты семплов (зависит от корректности работы тактовых сигналов с FGPA)
+STM32: Новая настройка "Freq Step WFM, kHz" для выбора шага перестройки в WFM моде, Tnx EA7HOG
+STM32: Добавлен диалог подтверждения форматирования SD карты, Tnx StevenSaH
+STM32: Исправлены ошибки при некорректном выборе CAT порта, Tnx UZ5DM

----Version 5.1.0----
+DOC: В readme файл добавлена ссылка на подробную инструкцию по функциям трансивера
+STM32: Добавлен пункт "Attenuation, dB" для выбора текущего затухания в аттенюаторе через меню
+STM32: Добавлено усреднение для замеров с MCP3008 для улучшения стабильности
+STM32: Исправлена работа Default+ темы в канальном режиме
+STM32: Скорректирована работа FFT Lens на 7 дюймовых дисплеях
+STM32: Mic Gain теперь регулируется в децибеллах и с повышенной точностью, Tnx R7KBI
+STM32: Доработка процесса обновления списка сетей WiFi, Tnx АлександрDX
+STM32: В калибровки добавлен диапазон регулировки усиления ПЧ (минимум\максимум), Tnx EA7HOG
+STM32: Изменены коэффициенты FFT компрессора
+STM32: В меню калибровок добавлены пункты сброса настроек и калибровок по умолчанию, Tnx DL1EGQ
+STM32: Добавлена возможность импорта\экспорта настроек функциональных кнопок на SD, Tnx RU4PN
+STM32: Доработки по тракту USB->TX и компрессора
+STM32: Реализован сервис отображения ионограмм через интернет (для выбранного URSI Code, для стран где это доступно), Tnx EA7HOG

----Version 5.0.0----
+STM32: Реализована возможность передачи на 70cm (432 MHz) диапазоне в режиме работы на гармонике (применимо для CW, FM, требует полосового фильтра на входе усилителя)
+STM32: Новые темы оформления "Default+" и "Analog+" для 7 дюймовых дисплеев, Tnx автору LZ1HAA
+STM32: Новая функция "Flash GT911" в калибровках, обновляет прошивку тачпада под разрешение экрана (актуально при покупке ненастроенных), Tnx R6DTB
+STM32: Увеличена чувствительность FFT в моде WFM
+STM32: Увеличены границы регулировки HPF, Tnx RC9M
+STM32: Новая калибровка "DAC Driver Mode" - режим работы драйвера OPA2673 (2 = 100% bias, 1 = 75% bias, 0 = 50% bias)
+STM32: Доработка отображения ячеек памяти на 7 дюймовом дисплее, Tnx EA7HOG
+STM32: Долгое нажатие на Play открывает файл-менеджер (для 7 дюймов), Tnx EA7HOG
+STM32: X1: Во время передачи блокируются функциональные кнопки (во избежание помех), Tnx RU4PN
+STM32: Новая контрастная тема для водопада (WTF) "BlR>Y>R", Tnx R7KBI
+STM32: Функция Scan при активном канальном режиме перебирает каналы, а не частоты, Tnx Radek
+STM32: Доработки отображения в сервисе Propagination, Tnx EA7HOG
+STM32: Начальная поддержка прототипа Wolf-Mini, Tnx R7KBI
+STM32: Различные доработки по использованию трансивера в CW моде, Tnx UA3RF, RA3RFA, UA3RJ
+STM32: Новый режим FFT Scale Type: Squared, позволяющий вытягивать слабые сигналы на спектре
+STM32: Исправление разных ошибок и недоработок, Tnx R4HID, R7KBI, UT8EU, R3DBQ, RU4PN, C1-49, ivan

----Version 4.4.0----
+STM32: Wolf-Lite: доработка внешнего вида, Автор R7KBI
+STM32: Корректировка времени срабатывания FM SQL, Tnx R8LBZ
+STM32: Новый алгоритм расчёта для регулировки уровня выходной мощности, Tnx BH4PJB
+STM32: Filemanager перенесён из меню Services в SD Menu, Tnx R4HID
+STM32: Калибровка "MAX RF Power" переименована в "MAX PWR on Meter", Tnx Serge I.
+STM32: Скорректировано отображение аналогового с-метра для измерения малых мощностей < 20 ватт, Tnx АлександрDX
+STM32: Добавлены калибровки для 4м диапазона, Tnx EA7HOG
+STM32: Wolf-X1: Исправление отображения некоторых пунктов меню, Tnx R7KBI
+STM32: Wolf-X1, Wolf-Lite: Добавлена настройка шага регулировки громкости вторичным энкодером, Tnx R7KBI
+STM32: Wolf-X1, Wolf-Lite: IF Gain сохраняется индивидуально для каждого диапазона, Tnx С1-49
+STM32: Wolf-Lite: Драйвер больше не участвует в функции Autogain, Tnx С1-49
+STM32: Обновлены драйвера COM-портов (протестирована работа в Win 7 + Win XP SP3 на VirtualBox), Tnx UR5VLC, RC9M
+STM32: WF-100D: Новый алгоритм обновления сдвиговых регистров
+STM32: Доработка механизма работы памяти по бендам, Tnx RA6UAC
+STM32: Во время передачи запрещено движение по частоте вторичным энкодером, Tnx Sergey Iv
+STM32: Добавлена регулировка HPF в SSB через функции ENC2, Tnx RC9M
+STM32: Исправление разных ошибок, Tnx LZ1HAA, RC9M, RA4CGO, UT8EU

----Version 4.3.0----
+STM32: Добавлена поддержка плат Wolf-Lite (с ограничениями функционала относительно старшей версии), теперь проекты будут жить и развиваться совместно, Thx R7KBI
+STM32: Файлы, схемы и прочее от Wolf-X1 и Wolf-Lite объединены в единый репозиторий
+STM32: Исправление разных ошибок, Tnx R7KBI, Alexander, R6WAM, R4HID, sun, R8LBZ, R3MCD, RU4PN, LZ1HAA, R5ZX, UR5HBA
+STM32: Переработка метода чтения с SD
+STM32: Исправлена ошибка при повторной записи CQ Message, Tnx R9FDL
+STM32: Для 100 ваттных версий реализован запрет на обновление сдвиговых регистров во время передачи, для избежания помех и дребезга (кроме режима TUNE и во время работы вентилятора)
+STM32: Добавлен 4 метровый диапазон (активируется в калибровках), Tnx EA7HOG
+STM32: Добавлена кнопка Shift для смены раскладки на виртуальной клавиатуре, Tnx R4HID
+STM32: В программируемый ряд кнопок добавлен VOX (кнопки настраиваются в меню Screen), Tnx RU4PN
+STM32: WF-100D: Для унификации сброс настроек и калибровок происходит по нажатию F1+F8 (как в 7 дюймовой BIG версии)
+STM32: Доработки RDS декодера
+STM32: Повышение чувствительности CW декодера
+STM32: При клике по аналоговому с-метру во время передачи меняется режим отображения: SWR или мощность, Tnx R6WAM
+STM32: В меню Services добавлена карта терминатора (дня и ночи), для 7 дюймовой версии, Tnx UA3DPB 
+STM32: Расширены значения шагов для перестройки частоты, Tnx C1-49 

----Version 4.2.0----
+STM32: Кодовая база Wolf X1 объединена с Волком, теперь прошивка полностью открыта, а изменения синхронизированы, Thx R7KBI
+STM32: Доработки FM демодулятора
+STM32: Для NFM моды теперь доступен авто-Notch фильтр
+STM32: Ускорено срабатывание шумодава на FM, Tnx R8LBZ
+STM32: При отключенном TUNER, но активном ATU не происходит ложных переборов и индикаций, Tnx RA3WSA
+STM32: В меню добавлена индикация текущего КСВ для ручной настройки тюнера, Tnx RA3WSA
+STM32: Доработка логирования записей FT8, Tnx RU4PN
+STM32: Дополнительный IQ выход через USB устройство, позволяющий направить необработанные IQ данные текущего VFO для скиммера, Tnx UT8EU
+STM32: Мелкие доработки интерфейса
+STM32: Добавлен функционал микрофонного VOX (активация передачи голосом, проверьте что микрофон не размыкается кнопкой PTT)
+STM32: Добавлена возможность регулировки FM SQL через функциональный режим ENC2, Tnx UR6QW
+STM32: В меню Callsign, Locator, WiFi Password добавлена экранная клавиатура (для 7 дюймовой версии)
+STM32: Исправление разных ошибок, Tnx RU4PN, R7KBI, Alexander

----Version 4.1.0----
+FPGA: Исправления ошибок по TX
+STM32: Исправления в работе свайпа по FFT
+STM32: Начаты эксперименты с новым АРУ, включается опцией "AGC Spectral" (вкл по умолчанию)
+STM32: Доработан FFT BW Style, Tnx R7KBI
+STM32: Исправлены названия RIT/XIT/SPLIT в соответствии со стандартами, Tnx RA4CGO
+STM32: Доработки процесса инициализации WiFi, Tnx Saw
+STM32: Доработки FFT
+STM32: Доработки усреднений показаний датчиков
+STM32: При превышении защитного порога по КСВ, мощность сбрасывается до 20%, а не отключается полностью
+STM32: Новый режим выбора антенн 1RX/2TX, Tnx R6WAM
+STM32: В меню добавлена ссылка на FT8, Tnx RA9UAC
+STM32: Доработка управления смещением трансвертеров, Tnx UA9OLB
+STM32: В режиме Two signal Tune автоматический подбор значений ATU отключается, Tnx R4HID
+STM32: Новая калибровка "TSignal Balance" - задаёт баланс мощности в % между сигналами в режиме Two signal tune, Tnx R4HID
+STM32: Новая калибровка "Linear Pwr Control" - Задаёт линейный способ изменения амплитуды сигнала при регулировке мощности (если отключен - логарифмический), Tnx RU4PN
+STM32: 15 канал CB отмечен модой AM в бендмапе, Tnx R8LBZ
+STM32: Добавлены сетки частот ABDE для CB, Tnx R8LBZ
+STM32: Доработки оформления номеров канального режима, Tnx R8LBZ
+STM32: Оптимизирован размер прошивки
+STM32: Добавлен JPEG декодер для крупных изображений
+STM32: Новая стартовая картинка для 7 дюймовых дисплеев, Tnx UA3DPB
+STM32: При импорте/экспорте настроек с SD Card добавлен запрос подтверждения, Thx RU4PN
+STM32: При нажатии на ключ вне CW моды, он работает как педаль PTT
+STM32: Дополнительная функция второстепенного энкодера, позволяющая регулировать ширину LPF не заходя в меню, Tnx RC9M
+STM32: Добавлена настройка для регулировки порога срабатывания VAD детектора голоса (шумоподавитель для SSB моды и SCAN режима)
+STM32: Исправления мелких ошибок

----Version 4.0.3----
+FPGA: Исправления ошибок
+STM32: Исправления ошибок

----Version 4.0.2----
+FPGA: Доработки цепей TX, Tnx RA9N, RU4PN, R3MCD, UR5VLC, UN7LAS, UA9ULT
+FPGA: Исправления в работе двойного приёмника, Tnx Мистер X
+STM32: Увеличение максимальной мощности TX, Tnx RA9N
+STM32: Ссылка на меню сервисов добавлено в основное меню
+STM32: Доработки двухтонального генератора
+STM32: Доработка автоматического отключения ФНЧ (RF-RU4PN, WF-100D)
+STM32: Исправление работы изменения частоты основным энкодером на низких значениях Freq step, Tnx Sergey Iv
+STM32: При выходе из Self test восстанавливаются исходные настройки PRE/DRV/ATT/PGA, Tnx R4HID
+STM32: VAD шумоподавитель теперь может работать в режиме Dual RX, Tnx Мистер X

----Version 4.0.1----
+FPGA: Доработки цепей TX, Tnx RA9N
+STM32: Доработки цепей TX, Tnx RA9N
+STM32: При активном LCD Sleep timeout в FT8 больше не отключается экран, Tnx RU4PN

----Version 4.0.0----
+HARDW: Новая MOTHERBOARD-RA9UCN-mod-rev31: Доработана Charge Pump цепь, рекомендуется обновить свои трансиверы в соответствии с новыми номиналами, Tnx RA9N
+FPGA: Доработки и оптимизации
+FPGA: Сокращена лишняя разрядность
+FPGA: Объединены узлы RX_CIC, RX_CICCOMP, TX_CICCOMP, TX_CIC
+FPGA: Скорректирована частота DAC
+FPGA: Доработки по фильтрам TX/RX
+FPGA: Исправлена проблема с отсутствием приёма на 384кГц полосе с выключенным DRV
+FPGA: Исправлены периодические проблемы с TX
+STM32: Доработки Stereo FM, Tnx RU4PN
+STM32: Разные оптимизации
+STM32: Исправлено меню цветов FFT/WTF, Tnx UR6QW
+STM32: Доработка заставки, Tnx UA3DPB
+STM32: Долгое нажатие на иконку полосы вызывает меню настройки, Tnx UR6QW
+STM32: Доработка индикации RIT, Tnx UR6QW
+STM32: Исправлено движение пика максимума S-метра
+STM32: Исправлена работа AGC при переходе TX/RX, Tnx RC9M
+STM32: Добавлена калибровка "LNA Compensation", которая компенсирует увеличение значения S-метра при включении LNA, dBm, Tnx RA4CGO
+STM32: Поддержка FT8 декодера и передатчика для 7 дюймовой версии, Tnx DB5AT
+STM32: Доработки процесса соединения WiFi
+STM32: В самодиагностику добавлен тест TCXO, Tnx UN7LAS
+STM32: При длинном нажатии на диапазонную кнопку (WF-100D), запоминается  частота. При коротком частоты вызываются по кольцу (3 ячейки памяти на бенд), Tnx RA6UAC
+STM32: Доработки VCXO корректора, Tnx RA9N
+STM32: Доработки WiFi, Tnx RV3NX
+STM32: Доработки ATU
+STM32: Теперь мощность FT8 не ограничена настройками мощности Tune
+STM32: Доработки ADIF логгера FT8, Tnx RU4PN

----Version 3.5.1----
+STM32: Восстановлена работа звука по USB
+STM32: Изменена картинка загрузки на 7 дюймовой версии, Tnx UA3DPB

----Version 3.5.0----
+STM32: Новая настройка "Fine RIT Tune", при её активации RIT настраивается мультифункциональным энкодером, а не резистором. Tnx RL6MR
+STM32: Обновление системных библиотек
+STM32: Стрелка аналогового S-Метра стала более плавной, Tnx TGZ, UR6QW
+STM32: При настройке FFT Averaging более 10 начинается не только усреднение выборок, но и сглаживание результатов, Tnx TGZ
+STM32: Исправлена работа SQL на КВ (SSB/AM), Tnx UR6QW
+STM32: Исправлено отображение DNR в меню, Tnx UR6QW
+STM32: Во время передачи главный энкодер управляет мощностью, Tnx UR5VLC
+STM32: В течение 3-х минут после передачи TX ФНЧ не отключается (платы RU4PN, WF-100D), Tnx RU4PN
+STM32: При активации настройки Auto Input Switch происходит автоматическая подстройка источника звука (PTT - Mic, CAT/COM - USB), Tnx RC9M
+STM32: Улучшение звучания в Stereo FM, Tnx RU3KV, RU4PN
+STM32: Новая тема оформления FFT/WTF "Bl>B>Y>R"

----Version 3.4.1----
+STM32: Исправление ошибок с SD картой, Tnx R4HID, RD3Q, Мистер X
+STM32: Иконка FAN для 3'2 версии, Tnx Мистер X
+STM32: Восстановлен 3D FFT, Tnx RV9CT
+STM32: Усреднение показателей температурного датчика, Tnx KENWOOD
+STM32: Починен FFT Height 5 на 3'5 дисплеях в семисегментном режиме, Tnx DL1EGQ
+STM32: SPLIT/SHIFT не сбрасывал частоту при выключении, Tnx RL6MR
+STM32: Доработки CW через COM-порт, Tnx RC9M
+STM32: DNR вернулся на старые алгоритмы
+STM32: Исправление разных ошибок, Tnx UR6QW, DL1EGQ
+STM32: Расширены диапазоны настройки параметров Freq Step, Tnx R8LBZ
+STM32: Доработки ATU, Tnx RU4PN

----Version 3.4.0----
+FPGA: Выложены версии для 10 MHz и 20 MHz TCXO генераторов (требуется тестирование), Thx R7KBI
+STM32: Доработки обмена по WiFi
+STM32: При включении вентилятора отображается соответствующая иконка, Thx RU4PN, UR5VLC
+STM32: В моде CW прибавлено усиление, чтобы приблизить громкость к SSB
+STM32: Цвет границ водопада, при перестроении частоты, рисуется ближе к цветам водопада (вместо черного), Thx svyatoslavx
+STM32: В NFM/WFM модах на S-метре отображается граница срабатывания шумоподавителя, Thx UR6QW
+STM32: Меню запоминает выбранный пункт в каждом подменю при повторном входе, Thx UR6QW
+STM32: Алгоритмы DNR заменены на Speex, настройка DNR Level выбирает на сколько dB давить шум, Thx за код UA1ARN
+STM32: RTS и DTR поменялись местами (RTS - PTT, DTR - CW), Thx RC9M
+STM32: Доработки АРУ, чтобы он не задерживался на резких одиночных пиках, Thx RU4PN
+STM32: Добавлена поддержка бендов и трансвертеров на 70/23/13/6/3cm с ПЧ на 144МГц (требуется тестирование), Thx RC9M
+STM32: Добавлено управление внешними трансвертерами через разъём External (настраивается в калибровках, требуется тестирование), Thx RC9M

----Version 3.3.1----
+STM32: Исправлена работа энкодера на УКВ диапазонах, Thx Григорий Потемкин
+STM32: Добавлена настройка порога минимального уровня сигнала при срабатывании CW декодера, Thx R3MCD

----Version 3.3.0----
+HARDW: Новая RF-UNIT-BIG-RU4PN, Thx RU4PN
+HARDW: Новые платы корпуса и тангенты, Thx EA7GIB
+HARDW: Новая плата подключения аудио(и не только) разъёмов, Thx EA7GIB
+HARDW: Новая версия RF-UNIT-BIG-DB5AT на основе AFT05mp075nr1, Thx DB5AT
+HARDW: Новая версия плат корпуса от DB5AT
+STM32: Добавлена поддержка измерителя INA226, Thx DB5AT
+STM32: Доработки для версии WF-100D и RU4PN
+STM32: Доработки ATU
+STM32: ATU сохраняет значениям по бендам
+STM32: Функция Mic Noise Gate, обрезающая микрофонный сигнал ниже заданного в настройках уровня, Thx R6WAM
+STM32: Доработки FFT dBm Grid, Thx UR6QW
+STM32: Восстановлено приветствие на экранах загрузки 7 дюймовых моделей, Thx UA9ULT
+STM32: Добавлена настройка Tuner Enabled, позволяющая отключить антенный тюнер полностью, Thx RU4PN
+STM32: Добавлена калибровка ATU Averaging, позволяющая регулировать количество замеров при работе ATU, Thx RU4PN
+STM32: Увеличена частота обращений к SNTP серверу за точным временем, Thx RA9N
+STM32: Исправлние разных ошибок, Thx UA9ULT
+STM32: Исправлено округление частоты для акселератора энкодера, Thx RU4PN
+STM32: Долгое нажатие на MUTE отрубает УНЧ, но не кодек, Thx UT3UOR
+STM32: Исправлена работа CLAR в моде CW, Thx UR5YDW
+STM32: Добавлена настройка "FFT BW Style", переключающая оформление полосы приёма на FFT, Thx R7KBI
+STM32: Добавлен режим отладки в консоль "CAT"
+STM32: Управление CW/PTT перенесено на второй порт (см. настройки N1MM)
+STM32: Базовая поддержка CAT протокола TS-2000 (выбирается в калибровках)
+STM32: Добавлена настройка FFT Scale Type, меняющая стиль оси Y на FFT между амплитудой сигнала и dBm, что позволяет уместить больший динамический диапазон на экране (Полезно при ручной настройке диапазона FFT).
+STM32: Улучшено звучание в Stereo WFM режиме, Thx UR6QW
+STM32: Значение Mic Noise Gate в -120dbFS отключает его полностью, Thx UR6QW
+STM32: Настройки HPF фильтра разделены на RX и TX, Thx UR6QW
+STM32: При включенном Split во время передачи отображается частота с учётом смещения, Thx UR6QW
+STM32: Долгое нажатие на кнопку DNR (7 дюймов), вызывает из меню настройку DNR, Thx UR6QW
+STM32: Настройки цветов FFT и WTF разделены, Thx UR6QW

----Version 3.2.1----
+HARDW: В папку Case добавлены STL модели ручек энкодера для распечатки на 3д принтере, Thx автору EB4DYL
+HARDW: Добавлена поддержка измерителя INA226T-Thx добав-rev3, Thx RU4PN
+HARDW: Новая RF-UNIT-RU4PN-rev3, Thx и RU4PN
-Tandem VHF разведён прямо на плате
-Уменьшены ёмкости ФНЧ дорожек
-Добавлены места пайки экрана на входные фильтра УКВ-модуля
+STM32: Исправление водопада, декодера RDS/CW, Thx RU4PN, UA9ULT, UR4UOQ и другим
+STM32: Диапазон FFT Averaging расширен до 10, Thx Гена

----Version 3.2.0----
+HARDW: Новая 100 ваттная +ATU плата RF-UNIT-RU4PN-rev2, которая пришла на замену RF-UNIT-BIG, Thx автору RU4PN
+HARDW: Добавлены интерактивные монтажные схемы boastools, Thx автору EB4DYL
+HARDW: Добавлена новая экспериментальная материнская плата версии RA9UCN (при поддержке UA9ULT)
-фильтр T1 на входе заменен на обычный дроссель (L1001)и дополнительно развязана шина 13,8В идущая на стабилизатор 12В через L1002. Все эти дроссели, включая L37, унифицированы, типоразмер 0630.
-L7 и L37 заменены на меньший размер 7x7 мм (в работе проверены, не греются).
-Стабилизатор 7812 заменён на LM1086 (1085, 1084), т. к. при разнице потенциалов в 1,8 вольта 7812 стабилизировал условно.
-Линия TX к STM защищена диодом D1002 и зашунтирована (опционально) конденсатором C1001!
-Разъём MIC_IN2 заменён на трёхконтактный(добавлен PTT), с возможностью запайки с обратной стороны платы для удобства стыковки с FRONT UNIT.
-PTT на микрофонный разьем подается через перемычку R1003.
-Добавлен дроссель L9 в цепь питания УНЧ.
-Линейный аудиовыход с кодека выведен на разьём для экспериментов с внешним УНЧ.
-Премычка "BOOT" вынесена ближе к краю платы для удобства программирования.
-Увеличена ширина шин питания и добавлено количество переходных отверстий на них.
-По возможности разнесены проблемные для начинающих близкорасположенные детали.
-Добавлены отверстия для запайки выводов не SMD трансформаторов.
-Добавлены отверстия для запайки выводного кварцевого резонатора на 32768 Гц.
+HARDW: Добавлена новая экспериментальная лицевая панель 7 дюймов версии RA9UCN (при поддержке UA9ULT)
-Уменьшены габариты до 110,5*220 мм.
-Убраны фронтальные разъёмы (предполагается использование основных на MB).
-Ряд функциональных кнопок сделан скрытым (доступ снизу) ввиду их невостребованности.
-Разъём FPC-45 смещен до одного уровня с разъемом на MB, для устранения перекоса шлейфа.
-Картридер перенесен на лицевую сторону.
-Установлен угловой разъём на гарнитуру (J3 6P6C, но возможно понадобится приподнять на 0,7 мм LCD).
-DC-DC перенесён на другую сторону.
-Дроссель L1 заменён на меньший размер 7x7 мм.
-Добавлен дроссель L1001 для блокировки помех от DC-DC по цепи 12В.
-В цепь DCDC SYNC добавлен фильтрующий элемент R1011 (резистор или дроссель).
-Добавлена возможность запайки Wi-Fi модуля с внешней антенной (ESP-07s) с возможностью конфигурации резисторами (R1001-R1006).
-Напряжение питания основного энкодера(3 или 5В) задается перемычками R1009-R1010.
-Добавлены токоограничительные резисторы в цепи переменных резисторов (R1007, R1008).
-Добавлены блокировочные конденсаторы.

+FPGA: Улучшена коррекция VCXO, Thx RA9N
+STM32: Добавлена поддержка FT8 в режиме TX/RX (для версии 3'2 / 3'5 дюймов), Thx автору DB5AT
+STM32: Вернул тактование I2S/SPI от FPGA, были щелчки при передаче, Thx RU4PN
+STM32: ATU теперь не работает в УКВ диапазонах, Thx RU4PN
+STM32: Новая калибровка "SSB Power addition" - в режиме SSB прибавляет мощность к выбранной в настройках, Thx UR5YDW
+STM32: Отдельная настройка полосы фильтра для DIGI мод, Thx UR5YDW
+STM32: Новый резим КСВ анализатора - измерение в выбранных границах частот, Thx UR5YDW
+STM32: Теперь КСВ анализатор выводит частоту с минимальным КСВ, Thx UR5YDW
+STM32: Функция "LCD Sleep Timeout" - 7 дюймовый экран снижает яркость спустя некоторое время без активности пользователя, Thx DL1EGQ
+STM32: Исправление различных ошибок, Thx DJ0AK

----Version 3.1.0----
+HARDW: добавлена FRONT-UNIT-3.5-RA9UCN: Новая версия лицевой панели от RA9UCN
-Размеры платы уменьшены до одного размера с MB (187*77 мм.) при сохранении возможности установки 3,2" или 3,5" LCD.
-Разъём FPC-45 смещен до одного уровня с разъемом на MB, для устранения перекоса шлейфа.
-Предусмотрена запайка угловых разъемов по питанию и увеличены размеры отверстий под них.
-Картридер заменен на такой же, как и на FRONT-UNIT-7", и перенесен на лицевую сторону, чтоб не перекрывал энкодер.
-Добавлена возможность запайки Wi-Fi модуля с внешней антенной (ESP-07s).
-Для снижения высоты добавлены посадочные места под SMD электролитические конденсаторы C1001 и C1002 (470uF*25V).
-Увеличены отверстия под запайку механического энкодера и переменных резисторов.
-Надписи упорядочены и добавлены к кнопкам, для удобства отладки.
-Внимание! Кнопки выровнены в единую сетку, поэтому передние панели от прежних версий НЕ подойдут!

+HARDW: Новая MOTHERBOARD-RA9UCN-mod-rev30: Новая версия материнской платы редакции RA9UCN (заменила старую материнскую плату)
-Предусмотрена запайка углового питающего разъема и увеличены размеры отверстий под него.
-Защитный диод по входу питания
-L7 большего типоразмера
-Возможность запайки двух перемычек (R1001 и R1002) под U19 ("опторазвязка" USB), при её отсутствии, например.
-Увеличена ширина питающих дорожек.
-Отсимметрированы по диагонали отверстия под радиаторы U5, U10, U16, относительно их корпуса.
-Предусмотрены отверстия для запайки земляных падов у U8(DAC) и U16(ADC).
-U11 убрана из под шлейфа.
-Немного увеличены/симметрированы полигоны под некоторыми стабилизаторами.
-Освобождено место вокруг разъёмов под динамики и второй микрофон для возможности запайки XH2.54.
-Батарейный отсек скорректирован под более качественный с толстыми выводами.
-Увеличен вырез под провода и предусмотрены отверстия для их фиксации.
-Упорядочены надписи.

+STM32: Устранение ошибки в телефонном самоконтроле, Thx UA9ULT
+STM32: Доработки поддержки RF-UNIT-QRP, Thx UA9ULT
+STM32: Запрет смены диапазона/vfo во время передачи, Thx RM0A
+STM32: Доработки прёмного тракта/фильтров AM/NFM, Thx RA9N
+STM32: При нажатии на экранную кнопку ATT, появляется выпадающий список с типовыми значениями аттенюатора, Thx UT3NI
+STM32: В меню ручного управления тюнером выводятся значения в uH/pF, а не номером комбинации
+STM32: В дополнение к режиму Shift (отстройка частоты приёма от выбранной), реализован режим Split (отстройка частоты передачи от выбранной), Thx UR5YDW
+STM32: Возможность воспроизведения любого записанного wav файла в эфир (через файл-менеджер), а не только CQ, Thx RM0A
+STM32: Исправлена ошибка в работе кнопки Mute, Thx Pidgornyi Sergii
+STM32: Добавлена версия прошивки, позволяющая запускать трансивер без FRONT-UNIT (управление по USB), Thx R3MCD
+STM32: Исправлена 7ми сегментная тема для 3'2-3'5 дюймовой версии, Thx RA9UCN
+STM32: Доработки аналогового с-метра, Thx DL1EGQ
+STM32: Поддержка экспериментальной RF-UNIT-SPLIT со стороны прошивки (требуется тестирование)
+STM32: Поддержка экспериментальной RF-UNIT-RU4PN со стороны прошивки (требуется тестирование), Thx RU4PN
+STM32: Добавлена функция инверсии битов RTTY декодера, Thx RU4PN
+STM32: Устранение ошибок с RDS, Thx EA7GIB
+STM32: АПЧ SAM демодулятора сокращена до 300гц, Thx RU4PN
+STM32: RX эквалайзер теперь работает на оба канала, Thx RU4PN
+STM32: Исправлена SAM демодуляция в режиме двойного приёмника

----Version 3.0.0----
+HARDW: RF-UNIT-QRP_20W: Добавлена 20 ваттная QRP++ версия платы RF-UNIT, Thx автору DB5AT
+HARDW: RF-UNIT-SPLIT-rev3: Доработки шелкографии, переходов, контура, Thx UB3DKI
+HARDW: Добавлена плата PCB MIC MH-48 (папка Addons) для 7 дюймовой лицевой панели, Thx автору EA7GIB
+HARDW: RF-UNIT-QRP-rev22: Обновлены номиналы всех фильтров (TX/RX ФНЧ, ФВЧ, ДПФ) для достижения лучшего АЧХ, Thx Radist2
+HARDW: Начата поддержка версии WF-100D, Thx R6WAM
+FPGA: Поддержка функций самодиагностики
+STM32: В меню сервисов добавлена самодиагностика FPGA, MCP3008, STM32 EEPROM, WM8731, линий АЦП, Симметрии АЦП, ADC DRV, ADC PGA, LNA, ATT
+STM32: Новая настройка SelfHear Volume - регулировка громкости самоконтроля относительно общей громкости трансивера, Thx RM0A
+STM32: Переход на CMSIS 5.8.0
+STM32: На кнопки каналов памяти выведена сохранённая частота, Thx RM0A, DL1EGQ
+STM32: Новая настройка "Show Sec VFO" - включает отображение положения второго VFO на спектре
+STM32: Исправление мелких ошибок, Thx Sergey Iv
+STM32: Кнопки, EEPROM и SD теперь не требуют тактового сигнала с FPGA для работы
+STM32: Новая опция FFT DXCluster Timeout - таймаут отображения спотов с кластера, минутах, Thx RM0A 
+STM32: Новая опция CW PTT Type - тип перехода на передачу в CW: от ключа или от педали, Thx UA9ULT
+STM32: При установленной плате с ATU, во время передачи на экран выводятся значения текущих C и I тюнера, Thx DB5AT
+STM32: Новая опция WFM Stereo - включает стерео декодер FM станций (внимание: стерео имеется не на всех вещалках + стерео сигнал требует хорошей антенны из-за меньшей мощности)

----Version 2.9.1----
+STM32: Доработки в манипуляции CW через N1MM, управление PTT через RTS линию CAT порта, CW через DTR, Thx RM0A
+STM32: Расширены варианты выбора RTTY Shift, Thx R3MCD
+STM32: Самоконтроль CW при нулевой мощности, Thx RC9M

----Version 2.9.0----
+HARDW: BOM очищены от ошибок в номиналах/футпринтах
+STM32: Уменьшено моргание интерфейса при работе CW
+STM32: Доработана настройка TX Start Delay в режиме CW, Thx RA9N
+STM32: В меню калибровок добавлена возможность переворота экрана на 180 градусов, Thx RA6UAC
+STM32: Новая настройка CW DotToDash Rate, которая задаёт отношение длинны тире к точке, Thx UA3DPB
+STM32: Новая настройка CW Iambic Keyer, которая включает ямбический ключ, Thx UA3DPB
+STM32: Исправлена сетка частоты поверх спектра
+STM32: Исправление периодических проблем со звуком в режиме самоконтроля
+STM32: Исправлена ошибка, когда пытаешься проиграть файл быстрого вызова, не имея его на SD карте, Thx RM0A
+STM32: Доработан вывод FFT при ручной калибровке диапазонов сигнала
+STM32: Новая настройка FFT dBm Grid, выводящая сетку силы сигнала поверх спектра, Thx RM0A
+STM32: Новая настройка CW Key Invert, инвертирующая точку/тире на ключе, Thx UA9OLB
+STM32: Доработка алгоритма включения аттенюатора после отработки autogainer
+STM32: Новый сервис Locator Info, отображающий расстояние и азимут до корреспондента, Thx UT3NI
+STM32: Новый сервис Callsign Info, отображающий информацию о стране, области, азимуте и т.п., Thx UT3NI
+STM32: Новая настройка FFT DXCluster Azimuth, добавляющая азимут к выводу dx-кластера на спектре, Thx UT3NI
+STM32: Новая мода-декодер RTTY, а также новое меню Decoders, где находятся настройки декодеров, Thx EW3ABA

----Version 2.8.1----
+HARDW: Исправлена Motherboard rev30, Thx RA9UCN

----Version 2.8.0----
+HARDW: Добавлены платы лицевой и задней панели разработки EA7GIB
+HARDW: RF-UNIT-BIG-rev5: Добавлены блокировочные конденсаторы, Thx UR4QBP
+HARDW: RF-UNIT-BIG-rev5: Максимальная мощность увеличена до 100вт, исправлены ошибки, Thx DJ0AK
+HARDW: RF-UNIT-BIG-rev5: Многооборотные резисторы подстройки тока покоя ОК
+HARDW: RF-UNIT-BIG-rev5: Доработано управление LNA
+HARDW: Новая версия экспериментальной платы коммутации RF-UNIT-SPLIT-rev1 (управление фильтрами/усилителями/тюнерами в формате отдельных плат)
+HARDW: В обвязке LNA все версий RF-UNIT заменены конденсаторы на 1nf, для увеличения чувствительности
+HARDW: Ферритовые бусины заменены на BLM21
+HARDW: Motherboard rev30: Добавлена USB изоляция по линии VBUS
+HARDW: Motherboard rev30: На шлейф передней панели выведена линия синхронизации DC-DC для подавления помех на части бендов, Thx DL1EGQ
+HARDW: Motherboard rev30: Стабилизатор LM1085-3.3 заменён на более мощный LM1084IS-3.3
+HARDW: Motherboard rev30: Стабилизаторы FPGA (1.2, 2.5) и АЦП (3.3) заменены на более мощные, в корпусах DPAK, Thx Игорь @Q
+HARDW: Motherboard rev30: Увеличено количество переходных отверстий под АЦП
+HARDW: Motherboard rev30: Добавлены отверстия для крепления радиаторов к АЦП/FPGA/STM32, Thx RU4PN
+HARDW: FRONT-UNIT-7 rev5: Выведена линия синхронизации DC-DC для подавления помех на части бендов (для MOTHERBOARD-rev30 и новее), Thx DL1EGQ
+HARDW: FRONT-UNIT-7 rev5: Доработка трассировки питания, Thx Дмитрий Кириенко
+HARDW: FRONT-UNIT-7 rev5: Защитный диод по питанию дисплея, Thx R4DZ
+HARDW: RF-UNIT-QRP rev21, RF-UNIT-BIG-rev5: Добавлен разрядник по входу RX, Thx R4DZ
+HARDW: RF-UNIT-QRP rev21: Выходной трансформатор рекомендовано мотать 25омным кабелем, Thx R2AVB
+HARDW: RF-UNIT-QRP rev21: Добавлен выходной симметрирующий трансформатор, Thx RA9N
+HARDW: RF-UNIT-QRP rev21: Для ДПФ фильтра 145МГц добавлен режекторный фильтр FM бенда, Thx EA7GIB
+STM32: Ограничение нижнего уровня FFT спектра на передачу, Thx Alex
+STM32: Новая настройка Mic Boost, управляющая 20db усилителем микрофона в аудио-кодеке
+STM32: Доработки FFT спектра
+STM32: Увеличен предел настройки TX Start Delay (задержка при передаче), Thx RA9N
+STM32: Доработки ручного Notch-фильтра, Thx RU4PN
+STM32: При включенном режиме CLAR, частоты VFO-A и VFO-B изменяются синхронно, Thx Radist2
+STM32: Доработана поддержка N1MM, Thx UT7NI
+STM32: Для 7 дюймового интерфейса добавлена возможность сохранения частот в ячейки памяти (любимые частоты, в меню выбора бенда), Thx UR5YDW
+STM32: FM шумодав теперь регулируется в уровне dbm принимаемого сигнала, Thx EW2MS

----Version 2.7.0----
+HARDW: Релиз RF-UNIT-BIG-35W-rev4, 35 ваттная версия rf-unit с антенным тюнером, размером с 7 дюймовую лицевую. Рекомендуется снизить усиление драйвера ЦАП перед подключением (R59, R60)
+STM32: Реализована поддержка встроенного антенного тюнера (RF-UNIT-BIG)
+STM32: Исправления различных ошибок, Thx R4DZ
+STM32: Исправления работы аналогового измерителя на УКВ, Thx АлександрDX
+STM32: Доработки внешнего вида меток DX-кластера, Thx RU4PN
+STM32: Вывод полосы VFO-B на спектр, если он находится рядом с VFO-A, Thx R4HID(ex.RN4HAQ)

----Version 2.6.0----
+HARDW: Экспериментальная Motherboard rev28 доработана, исправленный rev29 готов для заказа
+STM32: Добавлено управление ножкой Mute для УНЧ (Motherboard rev28 и новее)
+STM32: Добавлено управление усилением драйвера ЦАП (Motherboard rev28 и новее). Снижает энергопотребление и улучшает ДД. Калибровка RF GAIN 0-100% - 50% мощности, 101-200% - 75% мощности. 201-300% - 100% мощности.
+STM32: Небольшие доработки работы с SD
+STM32: Доработки вывода DX кластера поверх спектра, Thx RU4PN
+STM32: Антенна переключается тапом по иконке на экране, Thx RU4PN

----Version 2.5.0----
+STM32: Добавлена поддержка тангенты Yaesu MH-48, в меню калибровки выбирается необходимая тангента (MH-36 / MH-48), обновлена схема подключения
+STM32: Изменение ZoomFFT от жеста тачпадом (разведение пальцев в стороны на водопаде)
+STM32: Добавлено меню калибровки КСВ для 6М диапазона, Thx UR5YDW
+STM32: В меню Services реализована функция записи коротких сообщений для быстрой передачи в эфир
+STM32: Кнопка Play воспроизводит в эфир записанное ранее быстрое сообщений (CQ, CQ ...)
+STM32: Связка DFU + сторожевой таймер больше не приводит к перезагрузке, Thx R4HID(ex.RN4HAQ)
+STM32: Доработки CW декодера, Thx RA9N
+STM32: Доработки оформления, Thx АлександрDX
+STM32: Доработки передачи в SSB, Thx EW3ABA
+STM32: Реализована обработка внешнего источника ALC, трансивер будет снижать усиление, пока напряжение на входе держится более 1 вольта.
+STM32: Добавлена сетка частот 2м диапазона, Thx UR5YDW
+STM32: Новая тема оформления для 7 дюймовой версии, Thx RZ1ZR
+STM32: Новый SAM демодулятор (синхро AM), Thx UR5YDW
+STM32: Вывод DX кластера на спектр, Thx UR5YDW

----Version 2.4.1----
+STM32: Расширен диапазон регулировки SWR FWD/REF Calibration, Thx R4DZ
+STM32: Доработка самоконтроля в CW, Thx UR5YDW
+STM32: Доработка индикации перегрузки, Thx UR5YDW
+STM32: Новый калибровочный параметр для регулировки задержки перед передачей (времени срабатывания реле), Thx UR5YDW
+STM32: Разделены калибровки КСВ метра для КВ и УКВ, Thx UR5YDW
+STM32: Доработки процесса обновления с SD, вывод возможных ошибок на экран, Thx R4DZ
+STM32: Исправление ошибок в Channel Mode, Thx R4HID(ex.RN4HAQ)
+STM32: Доработки инициализации SD карты, Thx DB5AT

----Version 2.4.0----
+HARDW: Доработки экспериментальной RF-UNIT-BIG-rev3, переход на RD16 + RD100
+FPGA: Доработки PLL
+STM32: Доработки импорта с SD
+STM32: Доработки настройки FFT Height, Thx АлександрDX
+STM32: Доработки передачи в SSB, Thx EW3ABA
+STM32: Добавлена функция калибровки мощности на диапазоне CB, Thx EW3ABA
+STM32: Доработки OTA
+STM32: Расширен диапазон регулировки FFT Height, Thx R4DZ
+STM32: Исправления КСВ-анализатора, Thx UR4UOQ, UR5YDW
+STM32: Доработка FM шумодава, Thx АлександрDX
+STM32: Включен сторожевой таймер, который выключает трансивер если он завис более чем на 5 секунд, Thx UR5YDW

----Version 2.3.6----
+STM32: Релизовано декодирование и вывод информации RDS в WFM моде (отключается в меню)
+STM32: Исправления различных ошибок, Thx Alexey, EW3ABA, RU4PN, UR1MO
+STM32: При выводе гигагерцовых частот (с трансвертера) выводятся разряды ГГц, МГц, кГц, без герц, Thx UT3NI
+STM32: Новая настройка - делитель шага перестройки частоты для CW моды, Thx Alexey
+STM32: Доработка FFT и переход на Keil 5.34, Thx Антон (linoobs)
+STM32: Новый режим работы АРУ с задeржкой в пиках сигнала, в меню выведены дополнительные настройки для максимума усиления и времени задержки, Thx RU4PN
+STM32: Доработки Beeper'а, Thx RA9N

----Version 2.3.5----
+FPGA: Исправление пути генерации RBF-файла, Thx Konstantin N. Savchenko
+STM32: Оптимизация некоторых частей кода, Thx Дмитрий Кириенко
+STM32: Исправление ошибок в темах оформления, Thx UT3NI, Антон (linoobs), R4HID(ex.RN4HAQ
+STM32: Настройки SQL сохраняются для каждого Бенда/VFO индивидуально, Thx Sergo K
+STM32: Настройки каждого из бендов сохраняются на SD карту, Thx Sergo K
+STM32: Шаг настройки CW Pitch снижен до 10гц, Thx UR5YDW
+STM32: Расширен диапазон настройки трансвертера, Thx UT3NI
+STM32: Реализована передача CTCSS субтона в FM
+STM32: Доработки WFM моды
+STM32: На экран выводится текущее значение ZoomFFT
+STM32: Для 7 дюймовой версии добавлена возможность регулировки ширины полосы и ZoomFFT с помощью нижнего ряда функциональных кнопок, Thx UR5YDW

----Version 2.3.4----
+FPGA: Исправлен номер версии
+FPGA: При компиляции автоматически создаётся RBF файл
+FPGA: Мелкие доработки
+STM32: Переработка механизма работы CW и реализация полноценного CW Pitch, Thx UR5YDW
+STM32: Проверка CRC при работе с SD картой
+STM32: Доработки SD-кардридера
+STM32: Возможность прошивки STM32 с SD карты (для BIN файлов, через файл-менеджер)
+STM32: Возможность прошивки FPGA с SD карты (для JIC файлов, через файл-менеджер)
+STM32: Добавлено уведомление о выходе новой версии прошивки (определяется по WiFi)
+STM32: Реализовано OTA обновление прошивки STM32 и FPGA через WiFi
+STM32: Исправление работы без FFT Compressor
+STM32: Исправлены ошибки при переключении частоты механическим энкодером на УКВ, Thx UT3NI
+STM32: Доработки CAT подсистемы, Thx Sergo K
+STM32: Долгое нажатие на кнопку SQL (7inch) открывает меню настройки шумодава
+STM32: Исправление в работе меню, Thx EW2MS
+STM32: Калибровка S-метра разделена для КВ и УКВ, Thx UA9OLB
+STM32: Доработки AM/FM моды, Thx EW3ABA
+STM32: Выведена новая калибровка для AM модуляции
+STM32: Доработки DNR2, уровень срабатывания DNR2 вынесен в настройки
+STM32: При перегрузке ЦАП выводится ошибка и медленно снижается усиление, чтобы нормализовать выход

----Version 2.3.3----
+HARDW: Доработки экспериментальной RF-UNIT-BIG
+HARDW: На схему LNA добавлена более мощная альтернатива PGA-103+ -> SPF5189Z, на выбор, для фанатов УКВ. Thx UA9MBQ, R9US
+STUFF: Добавлен логотип в векторе
+FPGA: Доработки буфферов RX, TX
+STM32: Добавлена базовая экспериментальная поддержка RF-UNIT-BIG и антенного тюнера (включается в меню калибровки)
+STM32: Добавлена поддержка Logger32, Thx UA4FTA
+STM32: Добавлена поддержка некоторых видов SD карт
+STM32: Добавлен сервис вывода данных из DX кластера
+STM32: В файловый менеджер SD добавлена функция воспроизведения записанных WAV файлов
+STM32: Доработки цифрового ALC
+STM32: Управление SSB/FM шумодавом вынесено на экран (7 дюймов), Thx EW2MS
+STM32: Управление комбинациями порта External в зависимости от диапазона вынесено в меню калибровки, Thx EW3ABA
+STM32: Частота дискретизации устанавливается для любой FM моды, а не только WFM
+STM32: Настройки частоты дискретизации сохраняются для каждого бенда, Thx Sergo K
+STM32: Разделены настройки входа (MIC/LINE/USB) для DIGI и других мод, Thx UR5YDW
+STM32: Самоконтроль на DIGI модах, Thx UR5YDW
+STM32: Возможность запрета передачи на выбранных диапазонах через меню калибровки, Thx R6WAM, UA3DPB
+STM32: Добавлен морской VHF диапазон, Thx UA3DPB
+STM32: Скрытые диапазоны (60m, Marine VHF) включаются через меню калибровки
+STM32: Добавлен "канальный" режим, где навигация по бенду идёт по сетке каналов.
+STM32: Добавлена сетка каналов Marine VHF бенда, Thx UA3DPB
+STM32: Добавлена сетка каналов CB(C), LPD433, PMR446
+STM32: В случае ошибки подключения модуля ESP-01 запускается его перезапуск, Thx EW2MS
+STM32: Релизован ввод частоты вручную на 7 дюймовых дисплеях, в окне выбора бенда нужно нажать на текущий, Thx UT3NI
+STM32: Раздельная настройка эквалайзера и компрессора на передачу в разных модах (раздельно SSB и AM/FM), Thx UR5YDW

----Version 2.3.2----
+STM32: Сохранённые пики функции FFT HoldPeaks не сбрасываются при перемещении по частоте
+STM32: Добавлена калибровка часового кварца (грубая и точная), меньше значения - быстрее время, Thx Dmitriy Sorokin
+STM32: Доработки обнаружения сетей WiFi, Thx АлександрDX, R6WAM
+STM32: Режим сканера теперь доступен не только в SSB, но и в FM моде (работает в паре с шумодавом), Thx Konstantin K
+STM32: Теперь в меню HPF/LPF фильтры можно выбрать с любым шагом, а не из списка предустановленных
+STM32: В файловый менеджер SD-карт добавлена функция удаления файлов
+STM32: Доработки и исправления ошибок

----Version 2.3.1----
+HARDW: Добавлены эскизы/герберы передней панели для 3'2 дюймовой версии, Thx Анатолий Ступаков
+HARDW: Добавлен эскиз передней панели для 7 дюймовой версии, Thx Валерий Гаврилов
+HARDW: Добавлена схема коммутации дополнительного ФНЧ для трансивера Волк, Thx R6WAM
+FPGA: Доработка фильтров
+STM32: Доработка функций вывода отладочной информации
+STM32: Оптимизировано использование CPU и памяти
+STM32: Расширена поддержка SDHC/SDSC/SDXC карт памяти до 16 Гб
+STM32: VFO переключается по касанию на частоту на экране, второй клик открывает панель диапазонов
+STM32: Переименованы пункты в меню WiFi, Thx EW3ABA
+STM32: Доработки в меню выбора сети WiFi, Thx EW3ABA
+STM32: В настройках разделены уровни отладки, на системную, отладку WiFi, отладку кнопок и отладку тачпада
+STM32: Ускорен вывод FFT / 3D FFT
+STM32: Обновлена версия CubeMX и библиотек
+STM32: В меню сервисов добавлен файловый менеджер для просмотра файловой структуры SD-карты памяти
+STM32: Вывод ошибок EEPROM на экран, а не только в консоль, Thx R4DZ
+STM32: HPF фильтры расширены до 600гц, Thx Sergey Iv
+STM32: Для WFM моды увеличен шаг перестройки второстепенным энкодером
+STM32: Доработки фильтров
+STM32: Реализован выбор ширины полосы спектра (48кГц, 96кГц, 192кГц, 384кГц), ZoomFFT приближает относительно выставленного значения. Чем шире полоса, тем больше нагрузка на CPU
+STM32: Для WFM моды ширина спектра автоматически переключается на выставленную в настройках (по умолчанию 192кГц), улучшено звучание FM-вещалок.
+STM32: Уменьшены всплески ZoomFFT при перемещении по частоте
+STM32: Функция Autogainer теперь автоматически управляет уровнем аттенюатора
+STM32: При переключении бендов сохраняются настройки выбранной антенны, Thx R6WAM
+STM32: Поправлено отображение активного VFO в режиме передачи в режиме CLAR
+STM32: Доработки и исправления ошибок, Thx R7KBI, NJ, R4HID(ex.RN4HAQ)

----Version 2.3.0----
+HARDW: Экспериментальная RF-UNIT-BIG-rev1: Прототип платы для отладки работы раздельных мощных оконечных усилителей, КСВ метров, ант-тюнера, фильтров
+HARDW: Экспериментальная Motherboard-rev28: Добавлено управление ножкой Mute для УНЧ
+HARDW: Экспериментальная Motherboard-rev28: Добавлено управление усилением драйвера ЦАП
+HARDW: Экспериментальная Motherboard-rev28: Обвязка CLK цепи ЦАП приведена к даташиту
+HARDW: Экспериментальная Motherboard-rev28: На разъём MIC выведен контакт PTT
+HARDW: Экспериментальная Motherboard-rev28: Добавлен стерео выход с УНЧ
+HARDW: Экспериментальная Motherboard-rev28: Добавлен USB изолятор ADuM4160
+HARDW: Экспериментальная Motherboard-rev28: Подключены выводы USB VBUS/ID
+HARDW: Экспериментальная Motherboard-rev28: Добавлена цепь управления вентилятором АЦП
+HARDW: Экспериментальная Motherboard-rev28: Добавлен стабилизатор на 12в для ЦАП
+HARDW: Экспериментальная Motherboard-rev28: Дополнительные слои земли и переходы
+HARDW: Экспериментальная Motherboard-rev28: Добавлены защитные диоды по линиям CPU_PW_ON, CPU_PW_HOLD
+HARDW: Все Front-Unit: опциональные конденсаторы основного энкодера заменены на 10nF
+HARDW: Front-Unit-7-rev4: Увеличена толщина дорожки VCC12_IN
+HARDW: RF-Unit-rev20: Добавлен 10кОм резистор по входу RX антенны
+HARDW: RF-Unit-rev20: Добавлены перемычки для измерения тока каждого из плеч оконечного каскада
+HARDW: RF-Unit-rev20: Добавлена сетка из переходов между слоями
+HARDW: RF-Unit-rev20: Изменён номинал резистора R31 на 1 ком для лучшего срабатывания преампа, Thx R6WAM
+HARDW: FRONT-UNIT-4-IPS-rev1: Добавлены герберы для новой фронт-панели на 4 дюйма с IPS матрицей, Thx Павел Д Непийвода, R7KBI
+STM32: Восстановлена работа WSPR маяка, Thx АлександрDX
+STM32: Доработки меню установки времени, Thx RV9CT
+STM32: Добавлена версия прошивки HX8357C-SLOW, для медленных экранов HX8357C, которые не справляются со стандартными таймингами
+STM32: Устранены некоторые баги в системном меню
+STM32: Настройки срабатывания вентилятора охлаждения оконечного каскада вынесены в меню калибровки (FAN Medium start, FAN Medium stop, FAN Full start). Подробности в файле README
+STM32: Настройки срабатывания защиты по температуре и КСВ вынесены в меню калибровки (MAX RF Temp, MAX SWR). Подробности в файле README
+STM32: Исправления в работе двойного приёмника, Thx R4HID(ex.RN4HAQ)
+STM32: Разделены настройки полосовых фильтров TX/RX, Thx R4DZ, R7KBI
+STM32: Доработки тракта TX, Thx R4DZ
+STM32: Доработки FM моды
+STM32: Добавлена калибровка TUNE Max Power, отвечающая за максимально возможную мощность в режиме Tune, при превышении сбавляет выход, Thx Александр Свибович
+STM32: Добавлен режим картридера, позволяющий работать с SD картой трансивера по USB (включается в меню SD)
+STM32: Доработан механизм записи эфира на SD
+STM32: К некоторым пунктам меню добавлено текстовое значение, вместо цифр
+STM32: К нижнему слайдеру меню добавлены стрелки, для прокрутки без свайпа
+STM32: Новая опция FFT Hold Peaks - сохраняет и выводит пики сигналов на спектре FFT
+STM32: Исправления работы WIFI, Thx EW3ABA
+STM32: Мелкие доработки и исправления ошибок

----Version 2.2.4----
+HARDW: Выложена раскладка кнопок 7 дюймовой панели (Front-Panel.xlsx)
+FPGA: Небольшие доработки
+STM32: Увеличены тайминги для HX8357C
+STM32: Исправлены замирания при переключении масштаба FFT
+STM32: Разделены калибровки прямого и отраженного каналов КСВ-метра, Thx АлександрDX
+STM32: Исправлено сохранение настроек на 2200м диапазоне, Thx R4HID(ex.RN4HAQ)
+STM32: Начата работа над новой темой оформления с 7-сегментными шрифтами, Thx US4LLU
+STM32: Доработки процесса инициализации тачпада GT911
+STM32: Доработка и оптимизация кода вывода FFT/WTF
+STM32: При сбросе настроек/калибровки выводится соответствующее уведомление
+STM32: Настройки компрессора TX вынесены в меню
+STM32: Добавлена возможность отключения автоматики и выставления порогов FFT вручную
+STM32: Исправление ошибок

----Version 2.2.3----
+STM32: Небольшие корректировки цветов оформления
+STM32: Ускорена отзывчивость с-метра для CW моды
+STM32: Исправление ошибок

----Version 2.2.2----
+HARDW: Добавлены PCB и гербер-файлы корпуса для 3'5 версии, автор Тихомир
+STM32: Доработан интерфейс переключения VFO на 7 дюймах, Thx Антон
+STM32: Подписи частот над сеткой FFT для 7 дюймов, Thx R6WAM
+STM32: Новая тема оформления со стрелочным индикатором, Thx R9US, Alex
+STM32: Включены подтяжки к питанию по линиям LCD, Thx EW3ABA
+STM32: Новый Digital Noise Reduction (второй, с регулировкой от IF Gain)
+STM32: Вывод иконки статуса SD карты, Thx EW3ABA
+STM32: Динамическое изменение точности FFT от скорости смены частоты
+STM32: Калибровка выходной мощности разнесена на каждый бенд индивидуально, Thx R4DZ
+STM32: Настроена система сборки Keil batch build, настройки экранов перенесены в индивидуальные target
+STM32: Улучшено звучание и исправлены ошибки в приёмном тракте, Thx R4HID(ex.RN4HAQ), R4DZ
+STM32: При переключении VFO применяются выбранные для бенда настройки DRV, PRE и т.п. , Thx R4HID(ex.RN4HAQ)
+STM32: Выведено сообщение при перегрузке ПЧ (IFO'verflow)
+STM32: Доработки по FM моде
+STM32: При записи эфира на SD в имя файла добавлена частота приёма, Thx R4HID(ex.RN4HAQ)
+STM32: Исправление ошибок, Thx R4HID(ex.RN4HAQ), R4DZ

----Version 2.2.1----
+HARDW: Удалён лишний защитный диод по линии PTT на 7 дюймовой версии
+FPGA: При отключении АЦП теперь нет ошибочных сигналов
+STM32: Исправление проблемы с USB 3.0, Thx R9US
+STM32: Поддержка переворота экрана у RA8875, Thx RZ6AT
+STM32: Доработки интерфейса на 7 дюймовой версии
+STM32: Возможность регулировки яркости экрана RA8875 через меню
+STM32: Новый дизайн выбора диапазонов на 7 дюймовой версии
+STM32: Доработки FFT, ZoomFFT, 3D FFT
+STM32: Новый параметр FFT Top: регулировка чувствительности FFT
+STM32: Поддержка до 3-х точек доступа WiFi одновременно, Thx Анатолий Ступаков
+STM32: Добавлены функции контроля стека
+STM32: Реализована функция записи эфира на SD карту
+STM32: Плавная перестройка частоты при тапе по экрану, Thx Сергей Титов
+STM32: Исправление ошибок

----Version 2.2.0----
+HARDW: Новая дополнительная плата-лицевая панель для 3'5дюймов. Thx Тихомир
+HARDW: Доработки QRP-ФНЧ платы. Thx Тихомир
+HARDW: PAM8403 заменён на PAM8406, на старых платах достаточно замкнуть 9ю ногу на землю после замены.
+STM32: Поддержка 7 дюймовых дисплеев RA8875 (800*480) + тачпада GT911
+STM32: Поддержка тангенты Yaesu MH-36 (в 7 дюймовой версии)
+STM32: Поддержка дисплея ST7796S. Thx Александр Иванов
+STM32: Доработки FFT/ZoomFFT
+STM32: Новая опция в меню: FFT HiRes - Повышение разрешения ZoomFFT за счёт большего накопления данных
+STM32: Новая опция в меню: WTF Moving - Смещение водопада вместе с изменением частоты
+STM32: Доработаны CW фильтры, Thx R4DZ
+STM32: Исправление ошибок

----Version 2.1.2----
+HARDW: Мелкие исправления оформления на схеме
+HARDW: MOTHERBOARD: Доработана обвязка УНЧ: R17(удалить), C35(замкнуть), R18(замкнуть), R8(заменить на 30кОм), C13(заменить на 1uF), вывод 10 PAM8403 подключен к земле
+FPGA: Переработан корректор частоты VCXO, улучшена работа УКВ диапазонов
+STM32: Исправление ошибок, Thx: Анатолий Ступаков, Nadir Saidoff, R4DZ, АлександрDX
+STM32: Добавлен режим проверки шины обмена с FPGA при запуске трансивера
+STM32: Улучшен механизм прошивки FPGA через STM32, Thx R4HID(ex.RN4HAQ)
+STM32: Немного уменьшен размер прошивки
+STM32: Новый пункт меню - вывод системной информации (версия прошивки, статус АЦП, VCXO и т.п.), Thx R4HID(ex.RN4HAQ)
+STM32: Расширен ассортимент фильтров CW от 100гц до 1000гц в шагом 50гц, Thx R4DZ
+STM32: Доработаны CW Gauss фильтры, Thx R4DZ
+STM32: Доработан CW ключ, Thx R4DZ
+STM32: Сглажены фронты CW сигналов, Thx R4DZ
+STM32: Новые оконные функции для FFT, по умолчанию используем Dolph–Chebyshev
+STM32: Улучшено качество и контрастность спектра, разрешение ZoomFFT
+STM32: Реализована работа трансивера с Windows 7
+STM32: Оптимизация кода
+STM32: Новая опция FFT Style: 4 вида отображения спектра: градиент, заливка, точки, контур

----Version 2.1.1----
+HARDW: Новая дополнительная плата-расширение с ФНЧ фильтрами. Thx Тихомир
+HARDW: RF-UNIT: изменение номиналов C38 и C80 с 1n до 100n  - улучшение АЧХ на 160/80м
+HARDW: RF-UNIT: изменение номиналов L39, L47, R32, R46, C111, C81 и тока покоя оконечника - улучшение линейности на всех бендах
+HARDW: MOTHERBOARD: исправление зазоров и настроек слоёв, теперь плата отображается в JLCPCB предпросмотре. Thx R7KBI
+HARDW: Новая, перерисованная схема от R7KBI (в папке Scheme/ALTIUM_DESIGNER/R7KBI), намного более привычная для Русских пользователей
+FPGA: Оптимизация и исправление ошибок
+STM32: Оптимизация кода
+STM32: Доработка кода вывода FFT
+STM32: Водопад стал более плавным при изменении частоты
+STM32: Доработан процесс выключения
+STM32: Отрезаны неиспользуемые части FFT спектра
+STM32: Режим линзы для FFT
+STM32: Режим 3D FFT
+STM32: Очистка буффера TX при переходе в режим приёма
+STM32: Поправка на КСВ метр для 2м диапазона
+STM32: Исправление ошибок, Thx R4HID(ex.RN4HAQ)

----Version 2.1.0----
+HARDW: Возможность измерения КСВ на сверх-малых мощностях, используя усилитель AD8307. Дополнительная плата расширения + изменения в коде. Thx Тихомир
+HARDW: 4-я нога драйвера OPA2673 посажена на землю, на старых версиях плат желательно соединить дорожки вручную. Thx R7KBI
+HARDW: Для улучшения стабильности на 145МГц, на плате Motherboard резистор R53 заменён на C55 номиналом 7.5pf
+HARDW: Для улучшения согласования входа оконечника на 145МГц, на плате RF-UNIT удален конденсатор C8, трансформатор T5 включен в широкополосном варианте, и добавлена согласующая цепь L48, C55
+HARDW: Мощность на УКВ поднялась до 5 ватт, убраны искажения. Заменены номиналы RF-UNIT R34, R38, новые трансформаторы по выходу
+FPGA: Оптимизация кода
+FPGA: Увеличена точность NCO
+STM32: Обновлен драйвер, добавлена поддержка Windows 7/8 (требуется тестирование)
+STM32: Исправлен шум DC-DC на некоторых частотах
+STM32: Рядом с температурой добавлен знак градуса, RF переменован в PA
+STM32: Сообщения об ошибках (например перегрузка по входу) перенесены над текст моды
+STM32: Для AM моды добавлен DC-фильтр
+STM32: Для CW моды теперь доступен фильтр с распределением Гаусса (приём пика в центре полосы)
+STM32: Отдельный параметр ZoomFFT для CW моды
+STM32: Новый пункт меню: запуск автообновления прошивки ESP-01 (для SDK2 и выше, при активном интернете)
+STM32: Релизован режим WSPR маяка
+STM32: Исправление ошибок

----Version 2.0.9----
+FPGA: Улучшены характеристики приёмника, ДД, фильтры и подавление зеркал
+STM32: Исправлено сохранение моды при смене диапазона и активном Bandmap
+STM32: Исправлено моргание при переходе в меню по горячим клавишам
+STM32: Меню теперь можно использовать без применения основного энкодера, только второстепенным + его нажатием
+STM32: Исправление ошибок
+STM32: Исправлено моргание некоторых элементов интерфейса
+STM32: Сокращение расхода CPU и памяти за счёт индексирования палитры цветов
+STM32: Графическое отображение конфигурации фильтров LPF/HPF и положение Shift, thx R6WAM

----Version 2.0.8----
+FPGA: Доработки функции обновления прошивки FPGA
+STM32: Исправления ошибок
+STM32: Изменения в карте диапазонов
+STM32: При неподключенной RF-UNIT не отображается отрицательная температура
+STM32: Для FM мод добавлен De emphasis фильтр

----Version 2.0.7----
+HARDW: На схеме исправлен тип кабеля в трансформаторе оконечного каскада
+HARDW: Изменён номинал R37 в RF-UNIT, thx Александр Иванов
+HARDW: Увеличены прощадки под D18, D23 в RF-UNIT, thx Анатолий Ступаков
+HARDW: Увеличены прощадки под C33, C34 в MOTHERBOARD, thx Анатолий Ступаков
+HARDW: Увеличены прощадки креплений у FPC разъёмов, thx Анатолий Ступаков
+HARDW: Увеличен диаметр отверстий разъёмов питания, thx Анатолий Ступаков
+HARDW: Батарейка заменена на отсек KLS5-CR1220-01, thx Анатолий Ступаков
+HARDW: Скорректированы координаты пинов питания 3'2 дисплея
+HARDW: Экспортированы Assembly PDF файлы
+FPGA: Улучшена точность VCXO коррекции
+FPGA: Оптимизация кода
+STM32: Исправление ошибок
+STM32: Добавлены всплывающие уведомления для некоторых функций
+STM32: Добавлена поддержка LCD HX8357C, R61581 (в тестовом режиме)
+STM32: Добавлен WIFI сервис - вывод информации по прохождению на КВ/УКВ
+STM32: Добавлен WIFI сервис - вывод информации по диплому RDA
+STM32: Заложен механизм смены темы оформления
+STM32: Оптимизация скорости кода
+STM32: Оптимизация потребления памяти
+STM32: Переход на DMA2D для функций заливки
+STM32: Добавлен диапазон калибровки мощности оконечного каскада 15-30МГц
+STM32: Настройка акселератора энкодера вынесена в меню калибровки
+STM32: Добавлена проверка контрольной суммы при считывании калибровки

----Version 2.0.6----
+HARDW: Оптимизированы цепи ЦАП, замена номиналов R34, R35, R16
+HARDW: Оптимизированы цепи Драйвера, замена номиналов R53
+HARDW: Оптимизированы цепи TCXO, замена номиналов R45, C134
+HARDW: На схеме указаны напряжения во всех точках ВЧ цепи TX материнской платы
+FPGA: Исправления по цепям TX
+STM32: Исправления по цепям TX

----Version 2.0.5----
+HARDW: Новая плата для дисплея ILI9486, Thx Тихомир
+HARDW: Новая плата-расширение Motherboard с УНЧ TS4994, Thx Тихомир
+STM32: Базовый функционал работы с SD: определение подключения, вывод размера тома
+STM32: Возможность форматирования SD карты через меню
+STM32: Бекап настроек теперь также хранится в EEPROM, а не только в SRAM
+STM32: Добавлена поддержка дисплеев ILI9486, Thx Тихомир
+STM32: Возможность экспорта настроек и калибровок на SD карту
+STM32: Возможность импорта настроек и калибровок из SD карты
+STM32: Оптимизирован и доработан код работы с EEPROM
+STM32: Настройки скорости SPI шины для SD, FRONT-UNIT и EEPROM вынесены в settings.h
+STM32: Исправление ошибок
+STM32: Новая настройка: ревербератор микрофона
+STM32: Доработки AGC, добавлен кольцевой буффер для анализа будущих семплов
+STM32: Режим быстрой регулировки WPM в CW моде с помощью дополнительного энкодера
+STM32: Поддержка разных цветовых тем оформления. Новая настройка "Color Theme" для переключения на лету
+STM32: Добавлена белая тема оформления
+STM32: Режим работы с трансвертером, отображение частоты с учётом смещения

----Version 2.0.4----
+HARDW: Исправление мелких ошибок на Motherboard, Thx Тихомир, Владимир Емельянцев
+HARDW: Пересчитаны BPF фильтры на более корректные и эффективные, Thx ideapad2009
+HARDW: Новый слот под SD карту (FRONT-UNIT)
+HARDW: Прототип платы под 7 дюймовый дисплей
+HARDW: Для избежания перегрузки LNA на КВ, уменьшены номиналы С112 и C120 (RF-UNIT)
+STM32: Приоритетные участки кода отправлены в ITCM память
+STM32: Начальный этап поддержки 7 дюймового дисплея RA8875 с тачпадом GT911
+STM32: Оптимизации частей кода
+STM32: Исправлена формула расчёта S-метра под разные режимы работы (PGA, DRV), Thx Тихомир
+STM32: Доработан Fast step вторичного энкодера
+STM32: Доработан AutoGainer, настройки сохраняются по диапазонам
+STM32: Исправлено дрожание температуры ОУ при промежуточных значениях
+STM32: Более плавная регулировка громкости
+STM32: Доработан AGC, разделены настройки для SSB и CW, Thx Сергей Туров
+STM32: Настройки сохраняются в два банка памяти по очереди
+STM32: Корректность сохранённых настроек проверяется контрольной суммой
+STM32: Вывод приветствия (напр. позывного) на экране загрузки

----Version 2.0.3----
+STM32: Исправление ошибок, щелчков
+STM32: Доработки AGC
+STM32: Компрессия пиков для предотвращения перегрузки FFT (настройка FFT Compressor)
+STM32: Изменён интерфейс, под водопад выделено больше места
+STM32: На S-метр добавлен кубик, отображающий пиковую амплитуду сигнала
+STM32: Звуковое подтверждение нажатия на кнопки (отключается через меню настроек)
+STM32: Новая настройка FFT Background, рисует градиентный фон за спектром
+STM32: SSB шумоподавитель на основе VAD (Voice Activity Detector), настройка VAD Squelch
+STM32: Режим сканера(поиска) сигналов SSB
+STM32: Динамический энкодер, автоматическое ускорение при высокой скорости вращения, Thx R3TJL
+STM32: Доработан AutoNotch
+STM32: Доработан AutoGainer
+STM32: Доработан анализатор спектра
+STM32: Добавлена защита оконечного каскада от перегрева и высокого КСВ
+STM32: Добавлена функция построения графиков КСВ по диапазону(ам)

----Version 2.0.2----
+HARDW: Добавлена широкая версия FRONT-PANEL, с более удобным расположением кнопок, но с другими креплениями, Thx R7KBI
+STM32: Исправлена ошибка с двойным приёмником, когда один канал в FM
+STM32: Исправлена работа S-метра
+STM32: Доработан внешний вид S-метра
+STM32: Доработан внешний вид FFT/WTF
+STM32: Реализована сетка на водопаде
+STM32: Частота ядра повышена до 480 MHz
+STM32: Доработан AutoGainer, проверяет наличие интермодов в LNA
+STM32: Dither и Randomizer АЦП включены по умолчанию
+STM32: Разделена поддержка дисплеев ILI9481 и HX8357B
+STM32: Улучшено отображение на ILI9481
+STM32: Исправление мелких ошибок
Thx to: коллегам из https://t.me/SDR_Radio за ценные идеи:
+STM32: Новая настройка FFT Height: занимаемой высоты FFT и водопада
+STM32: Новая настройка FFT Color: семь видов цветовой гаммы оформления спектра
+STM32: Вывод текущей ширины полосы на экран
+STM32: Вывод текущей температуры оконечного каскада и STM32 на экран
+STM32: Вывод RX/TX/Tune на экран
+STM32: Шрифт разряда герц уменьшен и стал светлее
+STM32: Выведено значение RIT
+STM32: Перенесены и перекрашены значки функций

----Version 2.0.1----
+HARDW: Пересчитан PLL фильтр DAC (номиналы): C36, C37, R44
+FPGA: Улучшена точность TCXO коррекции
+FPGA: Увеличена частота дискретизации ЦАП
+STM32: Улучшение качества FM модуляции
+STM32: TUNE в режиме FM даёт тоновый сигнал
+STM32: Исправлена ошибка ручного усиления
+STM32: Исправление мелких ошибок
+STM32: FFT стал менее размытым при смене частоты
+STM32: Выведено меню Services
+STM32: AGC учитывает особенности человеческого слуха (K-Weighting)
+STM32: Улучшена работа цифрового шумоподавителя
+STM32: Исправлены щелчки при переключении полосы пропускания
+STM32: Улучшено управление двойным приёмником
+STM32: Доработан Noise Blanker
+STM32: Оптимизирована скорость работы LCD
+STM32: Доработан AutoGainer

----Version 2.0----
+Трансивер теперь называемся "Волк"
+HARDW: Переключатель на 2 антенны
+HARDW: Отказ от шлейфа IDC в пользу FPC
+HARDW: Плоский SMD кварц 32.768кГц
+HARDW: Конденсаторы по выходам основного энкодера (по необходимости)
+HARDW: 10-pin ARM SWD разъём
+HARDW: Предохранители и защитный диод по питанию
+HARDW: Автоподстройка высокочастотного VCXO сигналом низкочастотного TCXO/GPS
+HARDW: Автоматическое управление частотой DC-DC преобразователя для устранения помех от его гармоник
+HARDW: Площадка для монтажа экрана над DC-DC преобразователем
+HARDW: Подтяжка к земле для SWR ADC
+HARDW: Больше кнопок на передней панели
+HARDW: Новый трансформатор оконечного каскада
+HARDW: Новый драйвер ЦАП OPA2673
+HARDW: Новый ЦАП с интерполяцией DAC5674
+HARDW: Отдельный порт для подключения усилителя/тюнера (BAND+PTT+TUNE)
+HARDW: Отказ от реле в пользу RF Switches в приёмном тракте
+HARDW: Отказ от пин-диодов в BPF
+HARDW: Отключаемое питание LNA
+HARDW: Регулируемый аттенюатор 0.5-31.5 дБ.
+HARDW: Обновлены LPF/HPF/BPF, добавлен 6 метровый диапазон
+HARDW: Входной порт для ALC и аварии от АМР
+HARDW: Термодатчик оконечника для управления вентилятором
+HARDW: Шоттки в КСВ метре
+HARDW: Крепление для радиатора на оконечном каскаде
+HARDW: Раздельное управление токами покоя оконечных транзисторов
+HARDW: Защитные диоды по входу PTT/KEY/аудио/ALC
+HARDW: Отключается динамик, когда включены наушники
+HARDW: Выход на плату дополнительного усилителя
+STM32: Управление смещением VCXO через настройки калибровок
+STM32: Обновление AutoGainer
+STM32: Подсветка области полосы приёма на FFT
+STM32: Регулировка скорости FFT и водопада из меню
+STM32: Вывод версии прошивки при старте
+FPGA: Исправление ошибок, оптимизация

----Version 1.9.4----
+STM32: Использование STM32CubeProgrammer для прошивки вместо старой утилиты, которая не умела писать больше 1Мб в ROM
+STM32: Исправление различных ошибок
+STM32: Обновлён и расширен бендмап
+STM32: Сохраняются настройки последней моды за пределами бендмапа
+STM32: При ручном выборе моды, она остаётся вне зависимости бендмапа, до очередного переключения бенда
+STM32: Вывод регионов бендмапа над FFT
+STM32: Трёхполосный эквалайзер приёмника
+STM32: Трёхполосный эквалайзер микрофона

----Version 1.9.3----
+HARDW: Отказ от второго ОУ в драйвере, с RD07MVS1 он не нужен
+FPGA: Обзор FFT расширен до 96кГц, улучшена работа моды WFM (широкополосное радиовещание)
+STM32: ШИМ для управления оборотами вентилятора
+STM32: Новый стиль S-метра // Thx to UR5NKA
+STM32: Удален неиспользуемый код управления яркостью
+STM32: Управление усилением AGC вынесено в настройки
+STM32: Новый способ переключения мод (группа->мода): LSB->USB, CW_L->CW_U, DIGI_U->DIGI_L, NFM->WFM, AM->IQ->LOOP
+STM32: Периодическая синхронизация времени через SNTP
+STM32: WiFi CAT интерфейс
+STM32: Доработки компрессора микрофона + регулировка усиления из меню
+STM32: Автоматический выбор источника сигнала при передаче
+STM32: Исправление ошибок

----Version 1.9.2----
+HARDW: Реорганизация схемы // Thx to BH8CGJ
+FPGA: Прошивка FPGA автоматически обновляется, если новая найдена и включена в прошивку STM32
+STM32: Водопад отрабатывает корректно при смене частоты
+STM32: Увеличена скорость FFT и водопада
+STM32: Управление энкодерами вынесено в меню калибровки
+STM32: Проверка кода с помощью PVS-Studio
+STM32: Обновление библиотеки CMSIS
+STM32: Декодер CW переработан
+STM32: Исправление разных ошибок

----Version 1.9.1----
+FPGA: Исправление ошибок
+STM32: Реализован AutoNotch
+STM32: Новый шумоподавитель DNR на спектральном алгоритме
+STM32: NoiseBlanker из проекта UHSDR
+STM32: Изменяемый шаг переключения частоты основным и дополнительным энкодерами
+STM32: Изменяемый шаг расстройки SHIFT
+STM32: Переход с ARMA Lattice фильтров ФНЧ и ФВЧ на Biquad фильтры с лучшими характеристиками
+STM32: Доработан анализатор спектра
+STM32: Применено RLE сжатие для логотипа и будущих элементов GUI
+STM32: Настройки трансивера перенесены в Backup SRAM микропроцессора, в EEPROM осталась только калибровка
+STM32: Автоматический отлов фазовых ошибок IQ в случае некорректного запуска FPGA
+STM32: Исправление ошибок

----Version 1.9----
+HARDW: Схема перенесена в Altium Designer // Thx to BH8CGJ
+HARDW: Переход на новый МК STM32H743VIT6
+HARDW: Универсальные посадочные места под текущие и миниатюрные ВЧ трансформаторы (вроде TC4-1T)
+HARDW: Новый фильтр питания
+HARDW: Защитный диод по входу ВЧ
+HARDW: Выход на модуль расширения с FPGA (для будущих экспериментов)
+HARDW: LVPECL вход тактового сигнала в FPGA
+HARDW: Кнопка включения с обратной связью от процессора
+HARDW: ADC перенесён на материнскую плату
+HARDW: DAC перенесён на материнскую плату
+HARDW: LCD заменён на 3'2 дюймовый, разрешением 480*320
+HARDW: EEPROM перемещён на общую SPI шину переферии
+HARDW: WIFI ESP8266 перенесён на переднюю панель
+HARDW: Добавлено управление сигналом OE в SN74HC595D (RF-UNIT)
+HARDW: Отключаемый МШУ/LNA предусилитель на входе
+HARDW: В BPF на диапазон 145МГц добавлены подстроечные конденсаторы
+HARDW: Переход на компактные ВЧ транзисторы в оконечнике RD07MVS1 / 2SK2975
+FPGA:  Добавлена возможность калибровки смещения ADC
+FPGA: Двойной приёмник (приём сразу двух частот/мод)
+STM32: Разрешение FFT увеличено до 1024
+STM32: Расположение элементов интерфейса вынесено в отдельный файл для быстрой кастомизации
+STM32: В режиме отладки в консоль выводится текущая загрузка процессора
+STM32: Кодек переключен в разрешение 32бит, FPGA и шина на 32бита, USB звук на 24бита
+STM32: Включенеи отладки в консоль через системное меню
+STM32: Добаботки и улучшения крутизны и количества фильтров HPF/LPF/HILBERT
+STM32: DC-корректор отключен для моды AM, NFM, WFM
+STM32: DC-корректор сохраняет состояние в EEPROM
+STM32: Для каждого диапазона отдельно сохраняются настройки AGC, PRE, ATT и прочие
+STM32: Несколько стилей отображения FFT/WTF на выбор
+STM32: Упрощена регулировка усиления при отключенном AGC
+STM32: STM32 измеряет опорное напряжение для уточнения значений АЦП
+STM32: Вывод температуры кристалла к консоль отладки
+STM32: Верификация EEPROM при записи/чтении
+STM32: EEPROM теперь может уходить в режим сна
+STM32: Меню калибровки трансивера (сервисное меню) с отдельной областью EEPROM

----Version 1.8.2----
+FGPA: Управление настройками CIC-компенсатора и DAC из STM32
+STM32: Корректный выбор моды при работе в программе JTDX
+FPGA: Исправления в режиме передачи / приёма
+STM32: Исправления процесса соединения с WIFI точкой
+STM32: Защита усилителя от большого КСВ
+STM32: Исправление ошибок, ускорение запуска и режим сна WiFi
+STM32: Заставка при запуске, меняется в lcd.h
+STM32: Доработки автокалибровки FFT
+STM32: Доработки AGC
+STM32: Экспоненциальный регулятор громкости
+STM32: Логарифмический регулятор мощности
+STM32: Регулировка усиления IF/ПЧ через настройки
+STM32: Телеграфный ключ теперь использует аппаратные прерывания
+STM32: Встроенный автоматический ключ (KEYER)
+STM32: Дополнительные горячие клавиши на клавиатуре
+STM32: Второй вариант отображения S-метра (выбирается свечка или линия) // Thx to UR5NKA
+STM32: Регулировка скорости срабатывания компрессора на передачу
+STM32: Дополнен README файл

----Version 1.8----
+STM32: Меню подключения к WIFI
+STM32: Автоматическая синхронизация времени через интернет (SNMP)
+STM32: Базовая реализация анализатора спектра
+STM32: Самоконтроль в CW
+STM32: Поддержка оптимизаций Ofast и LinkTimeOptimization
+HARDW: Отказ от китайских модулей, STM32 и FPGA перенесены на основную плату
+HARDW: Отдельная плата для передней панели (LCD+управление)
+HARDW: Переход на 16 битный АЦП LTC2208 и предусилитель LTC6400-20
+HARDW: Новая плата ЦАП с предусилителем
+STM32: Поддержка АЦП дизеринга
+STM32: Поддержка предусилителя, встроенного в АЦП
+STM32: Поддержка шифрования сигнала АЦП (Randomizer)
+STM32: Отказ от тачпада в связи с низкой надёжностью, переделка интерфейса под кнопки
+STM32: Возможность выбора окна FFT через меню (Hamming / Blackman-Harris / Hanning)
+DOCUM: Доработан README файл, добавлена инструкция и описание к настройкам
+STM32: При зажатой во время включения кнопке MENU происходит HARD-RESET (сброс настроек EEPROM)
+STM32: При длительном нажатии на кнопку MENU включается LOCK (блокировка клавиатуры и энкодера)
+STM32: Плавная отстройка от частоты трансивера ручкой SHIFT
+STM32: Функция CLAR, позволяющие разнести передачу и приём на разные банки VFO
+STM32: Добавлен вывод ошибок при переполнении стека/кучи с помощью Memory Protection Unit
+STM32: Дополнительная защита EEPROM во время выключения (использование двух блоков памяти поочереди)
+HARDW: 5 ваттный оконечный усилитель на дешевых IRF520
+HARDW: Кварцевый генератор заменён на 122.88МГц
+FPGA: Исправлен и доработан код TX/ЦАП
+STM32: Возможность калибровки мощности по диапазонам для выравнивания АЧХ
+STM32: Ускорена реакция FFT при переходе TX/RX
+STM32: Вывод статуса ALC-метра во время передачи
+HARDW: Новый измеритель КСВ Tandem Match
+STM32: Вывод прямой мощности, обратной, КСВ
+STM32: Двухсигнальный генератор в режиме TUNE (включается в системном меню)

----Version 1.7----
+STM32: Исправлен баг с калибровкой экрана
+STM32: Обновление до STM32Cube FW.F4.1.24.1
+FPGA: Шина обмена с STM32 теперь использует 8 двунаправленных бит (было 2 направления по 4 бита)
+FPGA: Изменена визуальных схема части TX
+FPGA: Фильтр Гильберта перенесён в FPGA
+STM32: Оптимизация памяти FFT
+STM32: Разделены IIR ФВЧ фильтры для SSB и других мод
+FPGA: Данные о максимальной амплитуде принимаемых сигналов (в т.ч. вне полосных) на выходе АЦП передаётся в STM32
+STM32: Автоматическое управление ФНЧ, ДПФ, предусилителем и аттенюатором в зависимости от мощности сигнала на входе АЦП
+STM32: Улучшена работа RX AGC (устранены щелчки)
+STM32: Улучшена работа с тачпадом
+STM32: Отключение HPF и AGC в DIGI
+STM32: Новый корректор DC составляющей
+STM32: При первом запуске трансивера вызывается калибровка экрана
+STM32: Новый алгоритм калибровки тачпада, учитывающий нелинейности сенсора
+STM32: Реализация Notch-фильтра с автоматическим расчётом коэффициентов для Biquad фильтра
+STM32: Из системного меню можно перейти в режим программирования через USB (DFU), скрипт для программирования FLASH.bat
+STM32: Доработано системное меню
+STM32: Базовая реализация CW декодера на алгоритме Гёрцеля
+HARDW: Новая материнская плата
+HARDW: Добавлен разъём подключения ключа с раздельными сигналами точка-тире
+HARDW: Выведены разъёмы подключения вспомогательного энкодера и кнопок управления
+HARDW: На плату добавлен разъём подключения WiFi модуля ESP-01
+HARDW: Аудио кодек переехал на материнскую плату
+HARDW: Добавлена возможность тактования ЦАП из FPGA
+HARDW: Обновлена плата RF-UNIT, теперь она совмещена с усилителем на ST PD55008-E
+HARDW: Добавлены управляющие выводы на вентилятор
+HARDW: Добавлен КСВ-метр
+STM32: В setting.h добавлена возможность переворота экрана
+STM32: Новая более точная калибровка тачпада по 9 точкам
+STM32: Оптимизация DSP кода и шины обмена | Thx to RA4ASN
+STM32: Управление вентилятором во время и после передачи
+STM32: Добавлена поддержка клавиатуры и вторичного энкодера на передней панели

----Version 1.6----
+HARDW: Обновлена плата АЦП
+HARDW: Подготовлены экспериментальные версии плат RF-UNIT и MOTHERBOARD
+STM32: Новый дизайн FFT от RA4ASN
+STM32: Кнопка A=B, копирующая настройки VFO
+STM32: DNR (цифровое шумоподавление)
+STM32: Исправление прерываний энкодера
+STM32: Мелкие исправления и доработки
+STM32: Новая, оптимизированная и упрощённая версия AGC
+STM32: Реализован Zoom FFT (приближение спектра) в 2,4,8,16 раз
+STM32: Управление полосовыми фильтрами на пин-диодах, ФНЧ и ФВЧ
+STM32: Управление аттенюатором -12dB
+STM32: Управление коммутацией TX/RX реле на плате
+STM32: Управление усреднением FFT через системные настройки | Thx to RA4ASN
+STM32: Уровень громкости теперь не влияет на громкость сигнала в USB | Thx to RA4ASN

----Version 1.5----
+HARDW: Обновлена разводка основной платы, исправлены ошибки и добавлены новые функции
+HARDW: На основной плате размещён УНЧ
+HARDW: Кварцевый генератор вынесен на основную плату, имеет выделенный стабилизатор
+HARDW: Новая схема питания на 5вольт с импульсным преобразователем
+HARDW: Отказ от китайского модуля AD9226 в сторону своей платы
+HARDW: Новый предусилитель (УВЧ)
+HARDW: Новый ЦАП с предусилителем
+HARDW: Переход на кварц 49.152 MHz для устранения разности в частотах дискретизации звука
+PROTO: Спроектирована плата ВЧ цепей (аттенюатор, ДПФ, ФНЧ, коммутация) - пока не проверено
+PROTO: Спроектирован прототип усилителя и КСВ-метра - пока не проверено
+FPGA: Отказ от проприетарного CIC модуля, дало сокращение используемых ресурсов и энергопотребления, можно собирать трансивер на EP4CE10
+STM32: Поддержка дисплея ILI9325 | Thx to RA4ASN
+STM32: Исправление FFT и водопада | Thx to RA4ASN
+STM32: Поддержка аппаратного CW ключа
+STM32: Поддержка TX/RX звука через USB | Thx to Genadi Zawidowski
+STM32: Большая оптимизация, доработки и исправление кода | Thx to RA4ASN

----Version 1.4----
+FPGA: При умножении в микшере RX отброшен неиспользуемый бит, сокращение ресурсов, увеличение чувствительности | Thx to Genadi Zawidowski
+FPGA: Улучшена работа CIC модулей, улучшена чувствительность
+FPGA: При переключении TX/RX неиспользуемые модули отключаются
+STM32: CW мода режим TX
+STM32: Управление CW ключом через DTR линию Debug порта
+STM32: Таймаут передачи после отпускания ключа (от дребезга реле)
+STM32: Заполнение LCD цветом и отрисовка квадратов происходит через DMA
+STM32: Расширение поддержки CAT комманд | Thx to RA4ASN
+STM32: Оптимизирована работа системного меню
+STM32: Усреднение FFT против резких всплесков сигналов | Thx to RA4ASN
+STM32: FFT/водопад в режиме передачи | Thx to RA4ASN
+STM32: Обмен IQ сигналов в четных зонах Найквиста
+STM32: Переход на ARM C Compiler 6
+STM32: Автоподавление постоянной DC составляющей сигнала с АЦП
+STM32: Улучшение модуляции AM/FM
+STM32: Регулируемая полоса модуляции FM
+Мелкие фиксы ошибок и доработки

----Version 1.3----
+Композитный USB (2 COM порта)
+Подключение по USB CAT (эмуляция Yaesu FT-450)
+Реализация PTT через CAT команду
+Доработки демодулятора (FM-SQL, LPF фильтрация)
+Исправлены ошибки TX + доработка аудио-компрессора (NOISE GATE)
+Базовые реализации режима TX для AM и FM моды
+Исправлены проблемы с буфером при TX
+Сохранение частоты при переключении между диапазонами
+Задержка 10мс перед подачей ВЧ при переходе в TX (для реле)
+Звуки нажатия на экран

----Version 1.2.2----
+Отображение ширины полосы на FFT
+Доработан АМ демодулятор - добавлен полосовой фильтр для приёма станций, которые находятся недалеко друг от друга по частоте
+Watchdog timer от зависаний
+Использован DMA для вывода водопада, ускорен его вывод
+Исправлена проблема с наводками на I2S от FSMC

----Version 1.2.1----
+Изменён уровень усиления AGC
+Доработана автокалибровка FFT при отсутствии сильных сигналов
+используется DMA для смещения водопада в памяти
+исправлены ошибки отображения на LCD в некоторых ситуациях
+исправлены баги со звуком

----Version 1.2----
+Новые шрифты в интерфейсе на основе Sans, новые цвета
+Очередь отображения данных в LCD (исправление визуальных глюков)
+Банки памяти VFO-A VFO-B
+CW_L/CW_U мода RX + смещение CW генератора
+Приём верхних зонах найквиста (УКВ) (если выключен LPF в предусилителе) + УКВ бендмап
+FM мода RX (режимы WFM/NFM)
+Регулировка RF усиления на входе аудио-процессора
+Исправлены косяки на главной плате
+Системное меню настроек (настройки CW генератора, энкодера и др.)
+Исправлен косяк с USB
+Доработка FFT и водопада
+Регулировка силы подсветки LCD
+Вывод ошибок при инициализации кодека, FPGA. Кодек не блокирует запуск устройства
+Отображение силы сигнала в dbm
+Снижение подсветки LCD за неактивностью

----Version 1.1----
+Возможность отладки по виртуальному USB порту (требуется удаление поднягивающего резистора линии USB D+ R21 на 1.5K) // functions.c
+Перевод кода на Quartus 18.1
+Обновление STM32Cube FW_F4 до 1.24
+Разработать единую плату
+Разобраться с FFT при низком сигнале
+Исправлено: Высота линий не пропорциональна силе сигнала, завышена в синей части.
+Исправление некоторых искажений звука
+AD9226: Sense оторвать от земли и соединить с VREF, сократит Vpp АЦП с 2вольт до 1вольта. Увеличение чувствительности в ~2 раза.
+Оптимизация скорости вывода текста на LCD
+Оптимизации скорости прошивки и баг-фиксы

----Version 1.0----
+Базовый релиз
