donzelot/Transceiver/(list of files, drawings)

Other design files:
Schematic/Wolf-2/Experimental/WL-VHF/WL_1.2G.SchDoc
Schematic/Wolf-2/Experimental/WL-VHF/WL_144.SchDoc
Schematic/Wolf-2/Experimental/WL-VHF/WL_430.SchDoc
Schematic/Wolf-2/Experimental/WL-VHF/WL_BPF.SchDoc
Schematic/Wolf-2/Experimental/WL-VHF/WL_CON.SchDoc
Schematic/Wolf-2/Experimental/WL-VHF/WL_RF_SWITCH.SchDoc
Schematic/Wolf-2/Experimental/WL-VHF/WL_RFFC.SchDoc
Schematic/Wolf-2/Experimental/WL-VHF/WL_VHF.PrjPcb
