donzelot/Transceiver/STM32/WOLF-2/Src/main.c

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
/* Includes ------------------------------------------------------------------*/
#include "main.h"
#include "fatfs.h"

/* USER CODE BEGIN Includes */
#include "INA226_PWR_monitor.h" //Tisho
#include "audio_processor.h"
#include "bootloader.h"
#include "codec.h"
#include "fft.h"
#include "fpga.h"
#include "front_unit.h"
#include "functions.h"
#include "images.h"
#include "jpeg_utils.h"
#include "lcd.h"
#include "lcd_driver.h"
#include "profiler.h"
#include "rf_unit.h"
#include "sd.h"
#include "settings.h"
#include "trx_manager.h"
#include "usb_device.h"
#include "usbd_cat_if.h"
#include "usbd_debug_if.h"
#include "wifi.h"
/* USER CODE END Includes */

ADC_HandleTypeDef hadc1;
ADC_HandleTypeDef hadc3;

CRC_HandleTypeDef hcrc;

DMA2D_HandleTypeDef hdma2d;

I2S_HandleTypeDef hi2s3;

IWDG_HandleTypeDef hiwdg1;

JPEG_HandleTypeDef hjpeg;

RTC_HandleTypeDef hrtc;

SPI_HandleTypeDef hspi2;
DMA_HandleTypeDef hdma_spi2_rx;
DMA_HandleTypeDef hdma_spi2_tx;

TIM_HandleTypeDef htim2;
TIM_HandleTypeDef htim3;
TIM_HandleTypeDef htim4;
TIM_HandleTypeDef htim5;
TIM_HandleTypeDef htim6;
TIM_HandleTypeDef htim7;
TIM_HandleTypeDef htim15;
TIM_HandleTypeDef htim16;
TIM_HandleTypeDef htim17;

UART_HandleTypeDef huart6;
DMA_HandleTypeDef hdma_usart6_rx;

PCD_HandleTypeDef hpcd_USB_OTG_FS;

DMA_HandleTypeDef hdma_memtomem_dma2_stream5;
MDMA_HandleTypeDef hmdma_mdma_channel0_sw_0;
MDMA_HandleTypeDef hmdma_mdma_channel1_sw_0;
MDMA_HandleTypeDef hmdma_mdma_channel2_sw_0;
MDMA_HandleTypeDef hmdma_mdma_channel3_sw_0;
MDMA_HandleTypeDef hmdma_mdma_channel4_sw_0;
SRAM_HandleTypeDef hsram1;

/* USER CODE BEGIN PV */
DMA_HandleTypeDef hdma_spi3_rx;
DMA_HandleTypeDef hdma_spi3_tx;
static char greetings_buff[32] = {0};
/* USER CODE END PV */

void SystemClock_Config(void);
void PeriphCommonClock_Config(void);
static void MPU_Config(void);
static void MX_GPIO_Init(void);
static void MX_DMA_Init(void);
static void MX_MDMA_Init(void);
static void MX_ADC1_Init(void);
static void MX_FMC_Init(void);
static void MX_I2S3_Init(void);
static void MX_RTC_Init(void);
static void MX_SPI2_Init(void);
static void MX_TIM3_Init(void);
static void MX_TIM4_Init(void);
static void MX_TIM5_Init(void);
static void MX_TIM6_Init(void);
static void MX_TIM7_Init(void);
static void MX_USART6_UART_Init(void);
static void MX_USB_OTG_FS_PCD_Init(void);
static void MX_ADC3_Init(void);
static void MX_TIM15_Init(void);
static void MX_TIM16_Init(void);
static void MX_TIM17_Init(void);
static void MX_DMA2D_Init(void);
static void MX_TIM2_Init(void);
static void MX_CRC_Init(void);
static void MX_IWDG1_Init(void);
static void MX_JPEG_Init(void);
/**
 * @brief  The application entry point.
 * @retval int
 */
int main(void) {
	/* USER CODE BEGIN 1 */
	// PWR hold
	MX_GPIO_Init();
	// Reset RF registers state
	RF_UNIT_UpdateState(true);

	/* USER CODE END 1 */

	/* MPU Configuration--------------------------------------------------------*/
	MPU_Config();
	/* Enable the CPU Cache */

	/* Enable I-Cache---------------------------------------------------------*/
	SCB_EnableICache();

	/* Enable D-Cache---------------------------------------------------------*/
	SCB_EnableDCache();

	/* MCU Configuration--------------------------------------------------------*/

	/* Reset of all peripherals, Initializes the Flash interface and the Systick. */
	HAL_Init();

	/* Configure the system clock */
	SystemClock_Config();

	/* Configure the peripherals common clocks */
	PeriphCommonClock_Config();

	/* USER CODE BEGIN SysInit */
	// System stabilization
	uint8_t tryes = 0;
	while (tryes < 3 && (!__HAL_PWR_GET_FLAG(PWR_FLAG_VOSRDY) || (RCC->CR & RCC_CR_HSERDY) == 0 || (RCC->BDCR & RCC_BDCR_LSERDY) == 0 || (RCC->CR & RCC_CR_PLL1RDY) == 0 ||
	                     (RCC->CFGR & RCC_CFGR_SWS) != RCC_CFGR_SWS_PLL1)) {
		SystemClock_Config();
		tryes++;
	}
	if (tryes == 3) {
		MX_FMC_Init();
		LCD_Init();
		LCD_showError("STM32 crystals error", false);
	}

// Stack protection
#define stack_addr 0x20000000
	MPU_Region_InitTypeDef MPU_InitStruct = {0};
	MPU_InitStruct.Enable = MPU_REGION_ENABLE;
	MPU_InitStruct.Number = MPU_REGION_NUMBER4;
	MPU_InitStruct.BaseAddress = stack_addr + 256; // growning down
	MPU_InitStruct.Size = MPU_REGION_SIZE_32B;
	MPU_InitStruct.SubRegionDisable = 0x0;
	MPU_InitStruct.TypeExtField = MPU_TEX_LEVEL0;
	MPU_InitStruct.AccessPermission = MPU_REGION_NO_ACCESS;
	MPU_InitStruct.DisableExec = MPU_INSTRUCTION_ACCESS_ENABLE;
	MPU_InitStruct.IsShareable = MPU_ACCESS_NOT_SHAREABLE;
	MPU_InitStruct.IsCacheable = MPU_ACCESS_NOT_CACHEABLE;
	MPU_InitStruct.IsBufferable = MPU_ACCESS_NOT_BUFFERABLE;
	HAL_MPU_ConfigRegion(&MPU_InitStruct);

	/* USER CODE END SysInit */

	/* Initialize all configured peripherals */
	MX_GPIO_Init();
	MX_DMA_Init();
	MX_MDMA_Init();
	MX_ADC1_Init();
	MX_FMC_Init();
	MX_I2S3_Init();
	MX_RTC_Init();
	MX_SPI2_Init();
	MX_TIM3_Init();
	MX_TIM4_Init();
	MX_TIM5_Init();
	MX_TIM6_Init();
	MX_TIM7_Init();
	MX_USART6_UART_Init();
	MX_ADC3_Init();
	MX_TIM15_Init();
	MX_TIM16_Init();
	MX_TIM17_Init();
	MX_FATFS_Init();
	MX_DMA2D_Init();
	MX_TIM2_Init();
	MX_CRC_Init();
	MX_JPEG_Init();
	/* USER CODE BEGIN 2 */
	// HRDW_GoToInternalSPIClock();

#ifdef HAS_TOUCHPAD
	GPIO_InitTypeDef GPIO_InitStruct = {0};
	GPIO_InitStruct.Pin = T_INT_Pin;
	GPIO_InitStruct.Mode = GPIO_MODE_INPUT;
	GPIO_InitStruct.Pull = GPIO_PULLDOWN;
	HAL_GPIO_Init(T_INT_GPIO_Port, &GPIO_InitStruct);
#endif

	// Reset RF registers state
	RF_UNIT_UpdateState(true);

	__HAL_RCC_CSI_ENABLE();
	__HAL_RCC_SYSCFG_CLK_ENABLE();
	__HAL_RCC_BKPRAM_CLK_ENABLE();
	HAL_EnableCompensationCell();
	println("\r\n----------------------------------");
	println("WOLF-2 Transceiver Initialization...");
	println("[OK] USB init");
	USBD_Restart();
	println("[OK] FIFO timer TIM7 init");
	HAL_TIM_Base_Start_IT(&htim7);
	println("[OK] ENC2 timer TIM16 init");
	HAL_TIM_Base_Start_IT(&htim16);
	println("[OK] Real Time Clock init");
	HAL_RTC_Init(&hrtc);
	println("[OK] Frontpanel init");
	FRONTPANEL_Init();

	println("[OK] Settings loading");
	bool reset_settings = false;
	bool reset_calibrations = false;
	bool go_dfu = false;

	if (PERIPH_FrontPanel_Buttons[34].state) { // go DFU (TUNE)
		go_dfu = true;
	}
	if (PERIPH_FrontPanel_Buttons[26].state) { // soft reset (F1)
		reset_settings = true;
	}
	if (PERIPH_FrontPanel_Buttons[26].state && PERIPH_FrontPanel_Buttons[24].state) { // Very hard reset (F1+F9)
		reset_calibrations = true;
	}

	if (reset_settings) {
		LoadSettings(true);
	} else {
		LoadSettings(false);
	}

	// DFU bootloader
	if (TRX.NeedGoToBootloader || go_dfu) {
		TRX.NeedGoToBootloader = false;
		SaveSettings();
		JumpToBootloader();
	} else {
		MX_IWDG1_Init();
	}

	println("[OK] Calibration & WiFi loading");
	if (reset_calibrations) {
		LoadCalibration(true);
	} else {
		LoadCalibration(false);
	}

	// Reset RF registers state
	RF_UNIT_UpdateState(true);

	TRX.Locked = false;
	println("[OK] LCD init");
	LCD_busy = true;
	LCD_Init();
	if (SHOW_LOGO) {
		strcpy(greetings_buff, "ver. ");
		strcat(greetings_buff, STM32_VERSION_STR);

		LCDDriver_Fill(rgb888torgb565(255, 255, 255));
		LCDDriver_printImage_JPEGCompressed(0, 0, IMAGES_logo800_NY_jpeg, sizeof(IMAGES_logo800_NY_jpeg));
		LCDDriver_printTextFont(greetings_buff, 30, (LCD_HEIGHT - 30), COLOR_BLACK, rgb888torgb565(255, 255, 255), &FreeSans12pt7b);

		// show callsign greetings
		uint16_t x1, y1, w, h;
		strcpy(greetings_buff, "Hello, ");
		strcat(greetings_buff, TRX.CALLSIGN);
		strcat(greetings_buff, " !");
		LCDDriver_getTextBoundsFont(greetings_buff, LAYOUT->GREETINGS_X, LAYOUT->GREETINGS_Y, &x1, &y1, &w, &h, &FreeSans9pt7b);
		LCDDriver_printTextFont(greetings_buff, LAYOUT->GREETINGS_X - (w / 2), LAYOUT->GREETINGS_Y, COLOR->GREETINGS, rgb888torgb565(255, 255, 255), &FreeSans9pt7b);
	}
	println("[OK] Profiler init");
	InitProfiler();

	println("[OK] RTC calibration");
	RTC_Calibration();

	println("[OK] RF-Unit init");
	RF_UNIT_UpdateState(false);
	println("[OK] FFT/Waterfall & ADC & TIM4 init");
	FFT_PreInit();
	FFT_Init();
	HAL_TIM_Base_Start_IT(&htim4);
	println("[OK] STM32-ADC Calibration");
	HAL_ADCEx_Calibration_Start(&hadc1, LL_ADC_CALIB_OFFSET_LINEARITY, ADC_SINGLE_ENDED);
	HAL_ADCEx_Calibration_Start(&hadc3, LL_ADC_CALIB_OFFSET_LINEARITY, ADC_SINGLE_ENDED);
	println("[OK] AudioCodec init");
	CODEC_Init();
	println("[OK] TRX init");
	TRX_Init();
	println("[OK] Audioprocessor & TIM5 init");
	initAudioProcessor();
	HAL_TIM_Base_Start_IT(&htim5);
	LCD_busy = false;
	LCD_redraw(true);
	println("[OK] Misc timer TIM6 init");
	HAL_TIM_Base_Start_IT(&htim6);
	println("[OK] CPU Load init");
	CPULOAD_Init();
	println("[OK] PERIPHERAL timer TIM15 init");
	dma_memset(&SDFatFs, 0, sizeof(SDFatFs));
	HAL_TIM_Base_Start_IT(&htim15);
	println("[OK] Digital decoder timer TIM17 init");
	HAL_TIM_Base_Start_IT(&htim17);
	println("[OK] FPGA init");
	FPGA_Init(false, false);
	println("[OK] WIFI timer TIM3 init");
	HAL_TIM_Base_Start_IT(&htim3);
	println("UA3REO Transceiver started!\r\n");
	TRX_Inited = true;

	if (CALIBRATE.INA226_EN) { //	if INA226 is activated then initialise
		INA226_Init();
	}

	// while(true){HAL_Delay(3000); SCB->AIRCR = 0x05FA0004; } //debug restart
	/* USER CODE END 2 */

	/* Infinite loop */
	/* USER CODE BEGIN WHILE */
	while (1) {
		/* USER CODE END WHILE */

		/* USER CODE BEGIN 3 */
		CPULOAD_GoToSleepMode();
	}
	/* USER CODE END 3 */
}

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
/* USER CODE BEGIN 4 */
// обработка вывода отладки
FILE __stdout;
FILE __stdin;

int fputc(int ch, FILE *f) {
#pragma unused(f)

	// SWD
	if (SWD_DEBUG_ENABLED) {
		ITM_SendChar((uint32_t)ch);
	}

	// USB
#if HRDW_DEBUG_ON_CAT_PORT
	if (USB_DEBUG_ENABLED) {
		char usb_char = (char)ch;
		CAT_Transmit_FIFO((uint8_t *)&usb_char, 1);
	}
#else
	if (USB_DEBUG_ENABLED) {
		char usb_char = (char)ch;
		DEBUG_Transmit_FIFO((uint8_t *)&usb_char, 1);
	}
#endif

	// LCD
	if (LCD_DEBUG_ENABLED) {
		print_chr_LCDOnly((char)ch);
	}

	return (ch);
}
/* USER CODE END 4 */

/* MPU Configuration */

void MPU_Config(void) {
	MPU_Region_InitTypeDef MPU_InitStruct = {0};

	/* Disables the MPU */
	HAL_MPU_Disable();

	/** Initializes and configures the Region and the memory to be protected
	 */
	MPU_InitStruct.Enable = MPU_REGION_ENABLE;
	MPU_InitStruct.Number = MPU_REGION_NUMBER0;
	MPU_InitStruct.BaseAddress = 0x60000000;
	MPU_InitStruct.Size = MPU_REGION_SIZE_1MB;
	MPU_InitStruct.SubRegionDisable = 0x0;
	MPU_InitStruct.TypeExtField = MPU_TEX_LEVEL0;
	MPU_InitStruct.AccessPermission = MPU_REGION_FULL_ACCESS;
	MPU_InitStruct.DisableExec = MPU_INSTRUCTION_ACCESS_ENABLE;
	MPU_InitStruct.IsShareable = MPU_ACCESS_SHAREABLE;
	MPU_InitStruct.IsCacheable = MPU_ACCESS_NOT_CACHEABLE;
	MPU_InitStruct.IsBufferable = MPU_ACCESS_NOT_BUFFERABLE;

	HAL_MPU_ConfigRegion(&MPU_InitStruct);

	/** Initializes and configures the Region and the memory to be protected
	 */
	MPU_InitStruct.Number = MPU_REGION_NUMBER2;
	MPU_InitStruct.BaseAddress = 0x38800000;
	MPU_InitStruct.Size = MPU_REGION_SIZE_4KB;

	HAL_MPU_ConfigRegion(&MPU_InitStruct);
	/* Enables the MPU */
	HAL_MPU_Enable(MPU_PRIVILEGED_DEFAULT);
}

/**
 * @brief  This function is executed in case of error occurrence.
 * @retval None
 */
void Error_Handler(void) {
	/* USER CODE BEGIN Error_Handler_Debug */
	/* User can add his own implementation to report the HAL error return state */
	println("error handled");
	/*while (1)
	{
	  LCD_showError("Error handled", true);
	}*/
	// LCD_showError("Error handled", true);
	/* USER CODE END Error_Handler_Debug */
}

#ifdef USE_FULL_ASSERT
/**
 * @brief  Reports the name of the source file and the source line number
 *         where the assert_param error has occurred.
 * @param  file: pointer to the source file name
 * @param  line: assert_param error line source number
 * @retval None
 */
void assert_failed(uint8_t *file, uint32_t line) {
	/* USER CODE BEGIN 6 */
	/* User can add his own implementation to report the file name and line number,
	   tex: printf("Wrong parameters value: file %s on line %d\r\n", file, line) */
	printf("Wrong parameters value: file %s on line %u\r\n", file, line);
	/* USER CODE END 6 */
}
#endif /* USE_FULL_ASSERT */
