donzelot/Transceiver/(commit log)

2024-01-29 Добавлена регулировка громкости самопрослушивания в CW
2024-01-29 PCF8575DBR заменен фунтпринт
    [WL_CON.SchDoc]
2024-01-29 Update PCF resistors
    [WL_CON.SchDoc]
2024-01-29 Update TX circuit
    [WL_1.2G.SchDoc, WL_144.SchDoc, WL_430.SchDoc, WL_CON.SchDoc, WL_PGA_ATT.SchDoc]
2024-01-29 Add VHF board PCF8575 support
2024-01-29 Revert "Update TX circuit"
    This reverts commit 1ca9c940d52777707400ee32824581fa3e91ee9a.
    [WL_1.2G.SchDoc, WL_144.SchDoc, WL_430.SchDoc, WL_CON.SchDoc, WL_PGA_ATT.SchDoc]
2024-01-30 Добавлена подтяжка к PCF8575
    [WL_CON.SchDoc]
2024-01-30 VHF Mixer Board calibrate settings
2024-01-30 Гнездо X3 заменено на 4-х пиновое
    [WL_CON.SchDoc]
2024-01-30 Удалена опция отключения самопрослушивания в CW Изменен порядок настроек в меню CW
2024-01-30 Исправление вывода даты в меню.
    [system_menu.c]
2024-01-30 Выключение режима MUTE вращение регулировки громкости. Выключение клавишей не отменяется.
2024-01-30 Исправленная обвязка RFFC2071
    [WL_BPF.SchDoc, WL_RFFC.SchDoc, WL_RF_SWITCH.SchDoc, WL_VHF.PrjPcb]
2024-01-30 Update capacitors
    [WL_RFFC.SchDoc]
2024-02-01 Изменена емкость конденсаторов фильтра на 144
    [WL_1.2G.SchDoc, WL_144.SchDoc, WL_430.SchDoc]
2024-02-01 145мГц заменен фильтр по RX
    [WL_BPF.SchDoc]
2024-02-01 Update SAW info
    [WL_BPF.SchDoc]
2024-02-01 Добавлена матричная обработка клавиш тангенты
2024-02-01 VHF switch button
2024-02-01 Fan by motherboard temp
2024-02-01 Exit button for decoder
